vberkaltun/nodemcu-firmware-documentation/thesis-material/mq-all.png

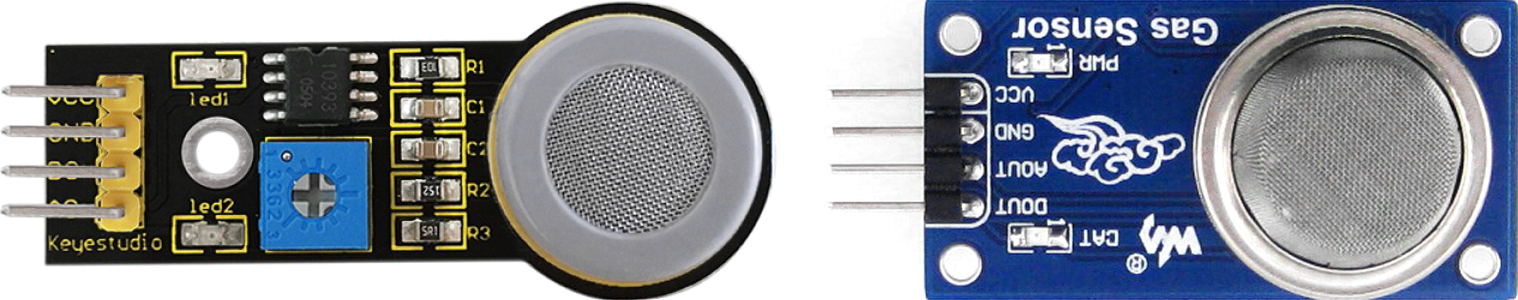
thesis-material/mq-all.png
