vberkaltun/nodemcu-firmware-documentation/thesis-material/IMG_8717.JPG

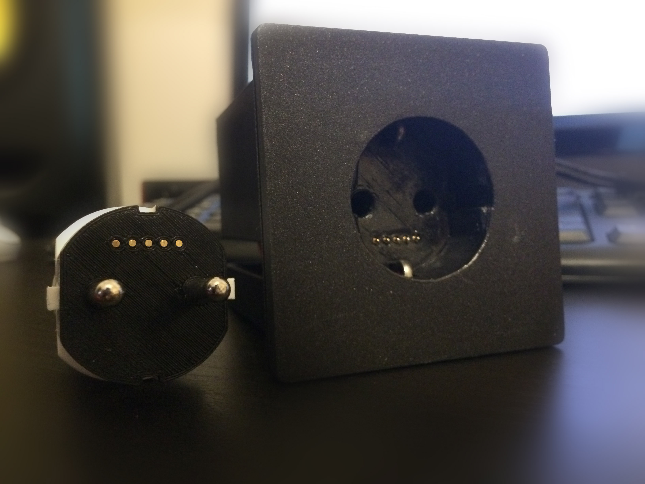
thesis-material/IMG_8717.JPG
