vberkaltun/nodemcu-firmware-documentation/thesis-structure/cover-out.docx

Pamukkale Üniversitesi, Mühendislik Fakültesi

Bilgisayar Mühendisliği Bölümü

Lisans Bitirme Tezi

Elektrik Sistemlerinin
Uzaktan Denetimi ve Yönetimi: intelliPWR

Tarafından

Veysel Berk ALTUN 13253004

Denetleyen

Yrd. Doç. Dr. Elif HAYTAOĞLU

Mayıs 21, 2018

Denizli
