vberkaltun/nodemcu-firmware-documentation/thesis-material/ATmega328-pinout.png

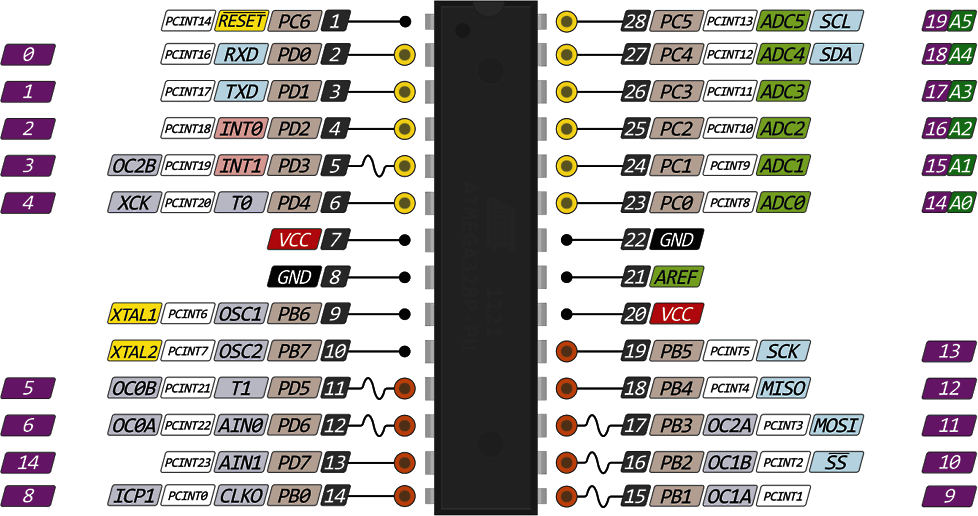
thesis-material/ATmega328-pinout.png
