vberkaltun/nodemcu-firmware-documentation/thesis-material/esp12-pinout.png

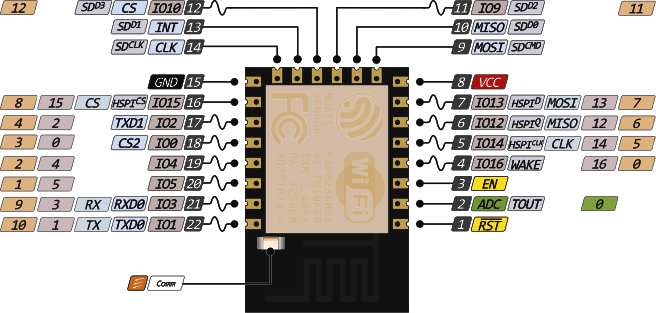
thesis-material/esp12-pinout.png
