vberkaltun/nodemcu-firmware-documentation/thesis-presentation/anime/anim_1.png

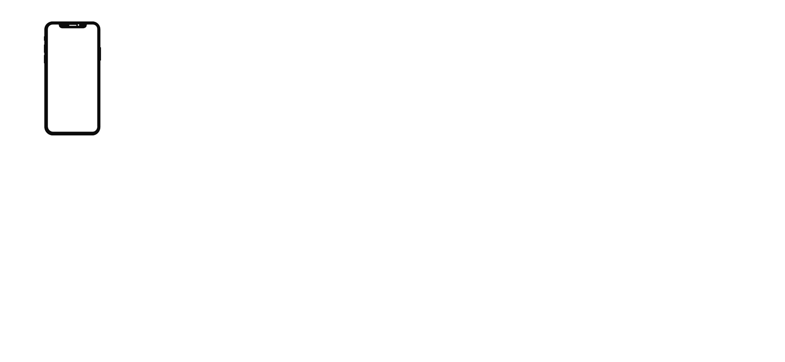
thesis-presentation/anime/anim_1.png
