vberkaltun/nodemcu-firmware-documentation/thesis-presentation/anime/anim_2.png

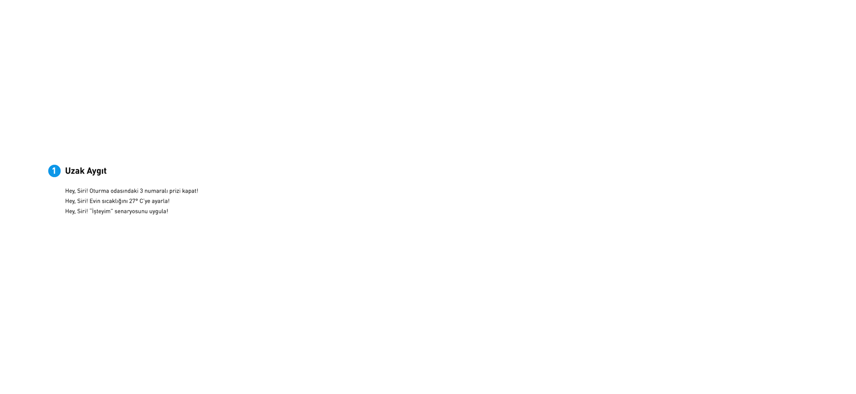
thesis-presentation/anime/anim_2.png
