vberkaltun/nodemcu-firmware-documentation/thesis-presentation/anime/anim_4.png

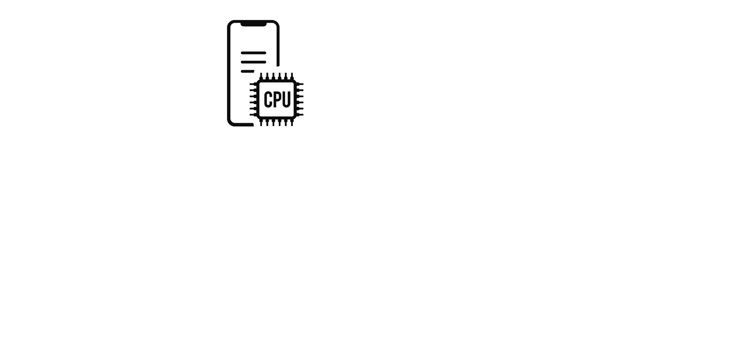
thesis-presentation/anime/anim_4.png
