vberkaltun/nodemcu-firmware-documentation/thesis-presentation/anime/anim_5.png

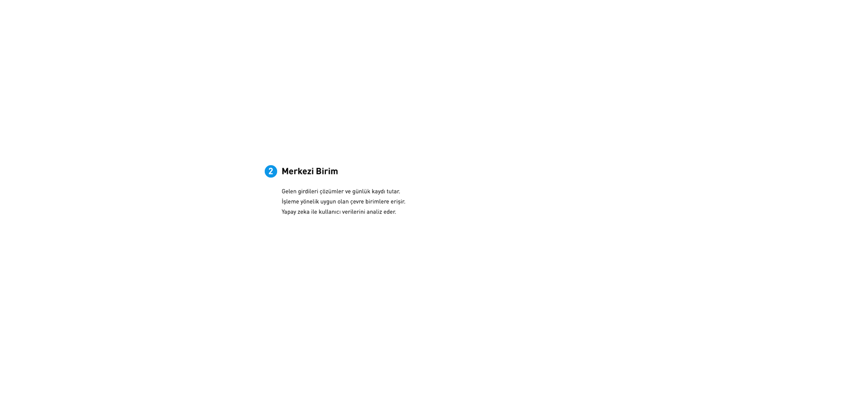
thesis-presentation/anime/anim_5.png
