vberkaltun/nodemcu-firmware-documentation/thesis-presentation/anime/anim_7.png

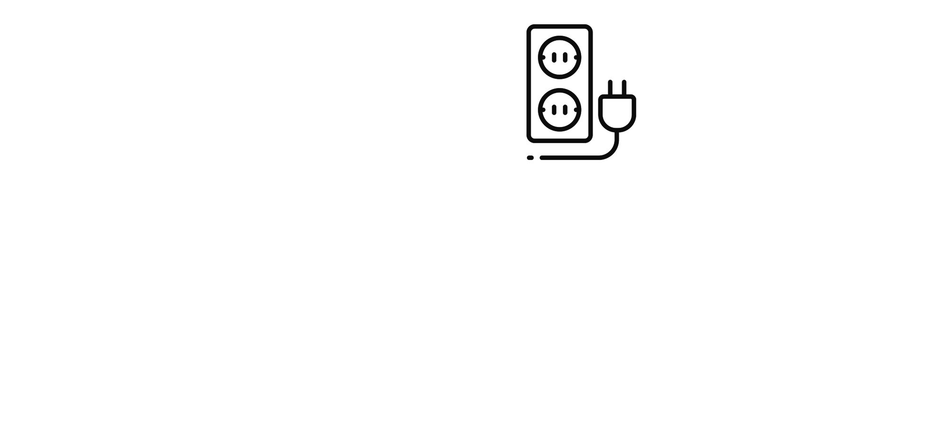
thesis-presentation/anime/anim_7.png
