vberkaltun/nodemcu-firmware-documentation/thesis-presentation/anime/anim_8.png

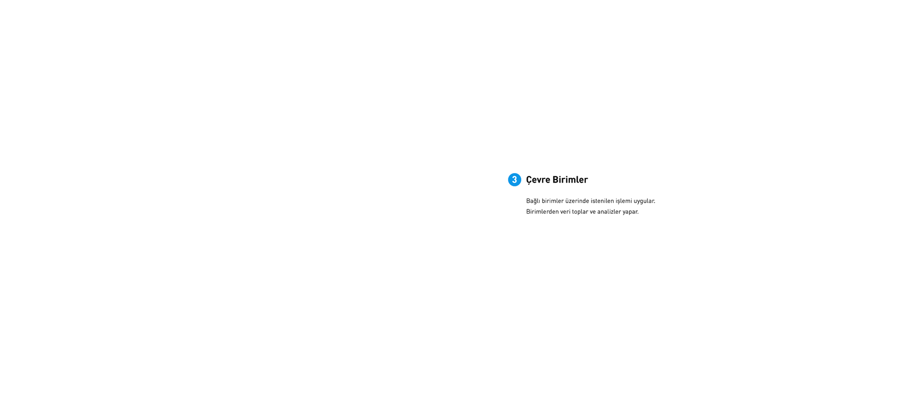
thesis-presentation/anime/anim_8.png
