vberkaltun/nodemcu-firmware-documentation/thesis-presentation/anime/anim_14.png

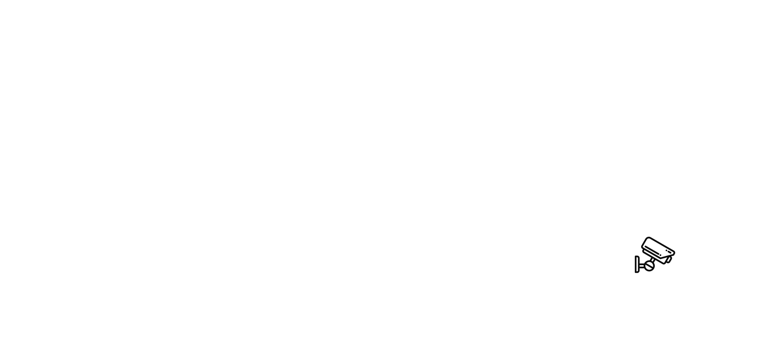
thesis-presentation/anime/anim_14.png
