vberkaltun/nodemcu-firmware-documentation/thesis-presentation/anime/anim_16.png

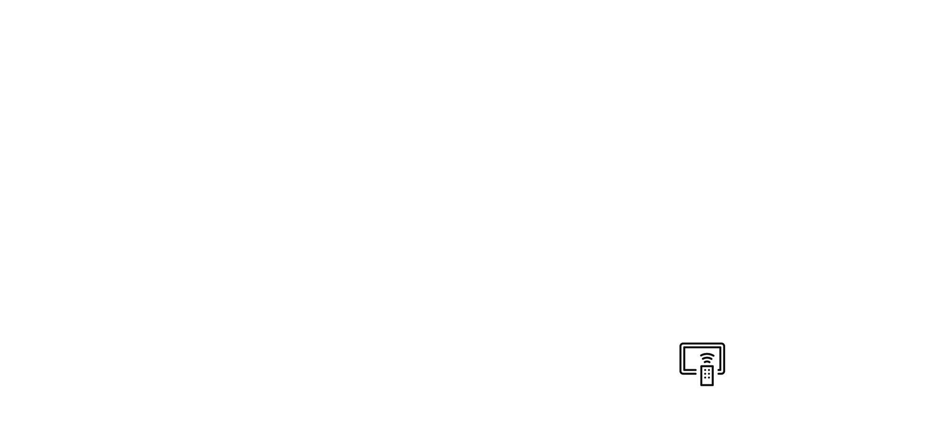
thesis-presentation/anime/anim_16.png
