vberkaltun/nodemcu-firmware-documentation/thesis-presentation/text/back_1.png

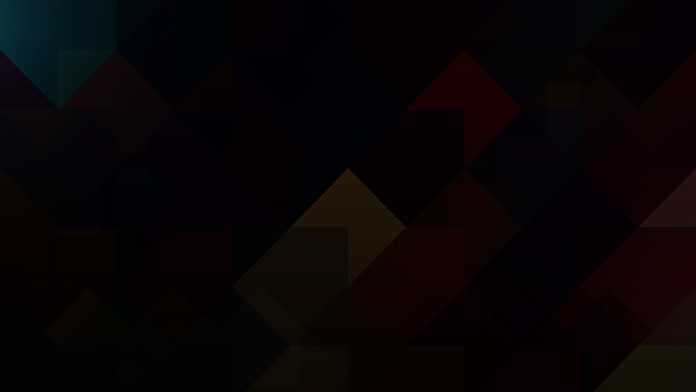
thesis-presentation/text/back_1.png
