vberkaltun/nodemcu-firmware-documentation/thesis-presentation/text/cap_2.png

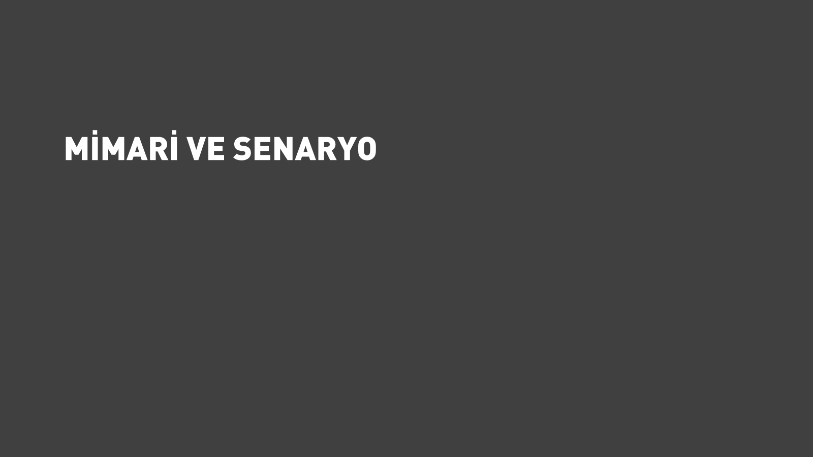
thesis-presentation/text/cap_2.png
