vberkaltun/nodemcu-firmware-documentation/thesis-presentation/text/cover_allinone_1.png

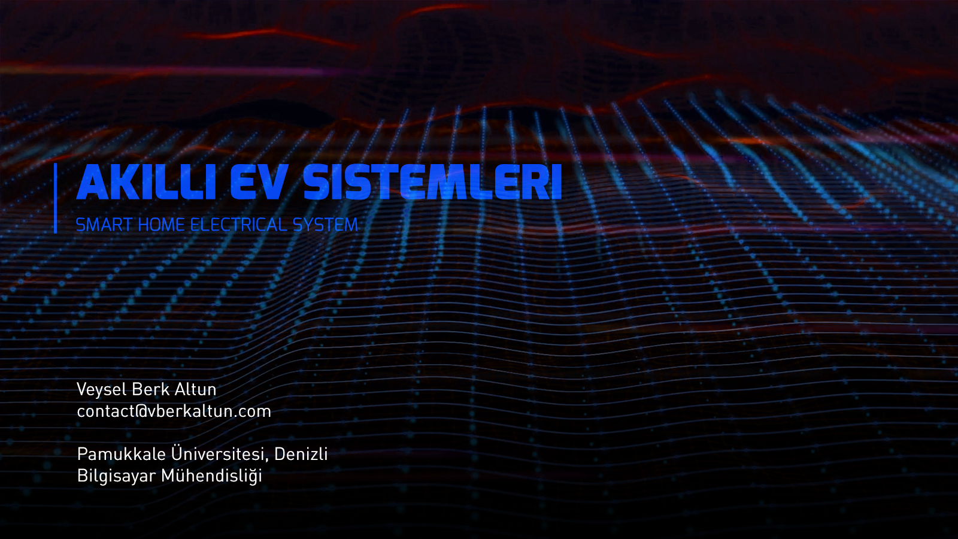
thesis-presentation/text/cover_allinone_1.png
