vberkaltun/nodemcu-firmware-documentation/thesis-presentation/text/cover_back.png

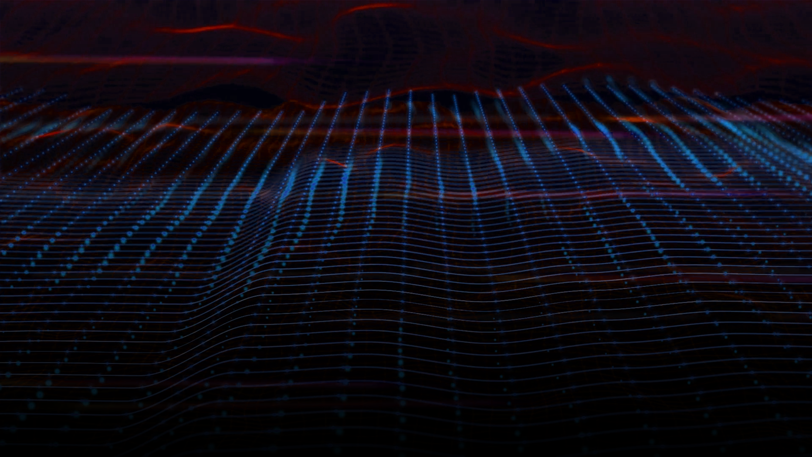
thesis-presentation/text/cover_back.png
