vberkaltun/nodemcu-firmware-documentation/thesis-presentation/text/cover_caption.png

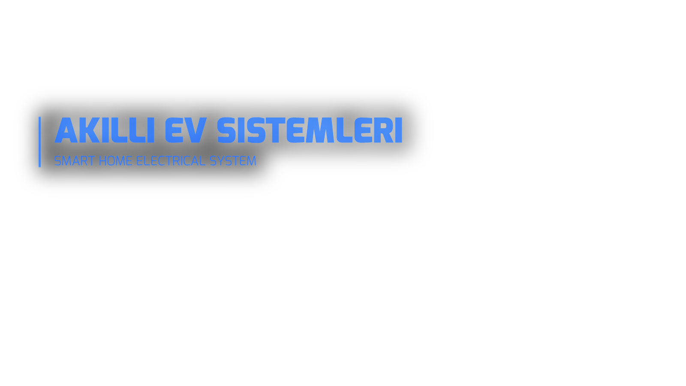
thesis-presentation/text/cover_caption.png
