vberkaltun/nodemcu-firmware-documentation/thesis-presentation/text/cover_subtitle.png

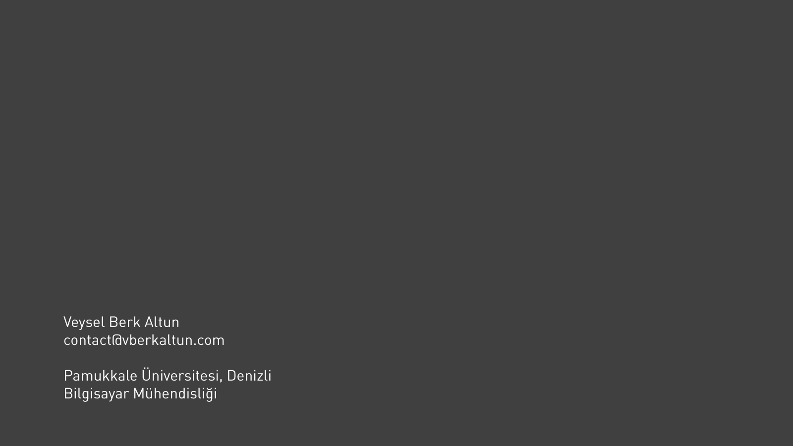
thesis-presentation/text/cover_subtitle.png
