vberkaltun/nodemcu-firmware-documentation/thesis-presentation/text/design_1.png

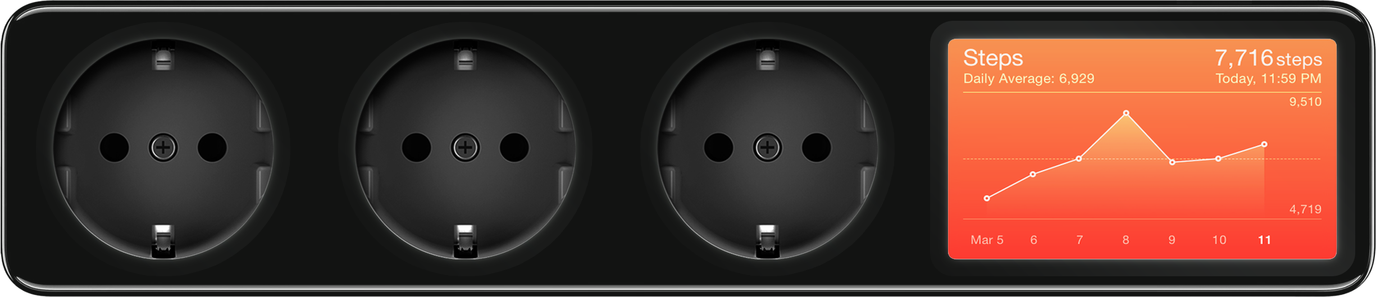
thesis-presentation/text/design_1.png
