vberkaltun/nodemcu-firmware-documentation/thesis-presentation/text/design_2.png

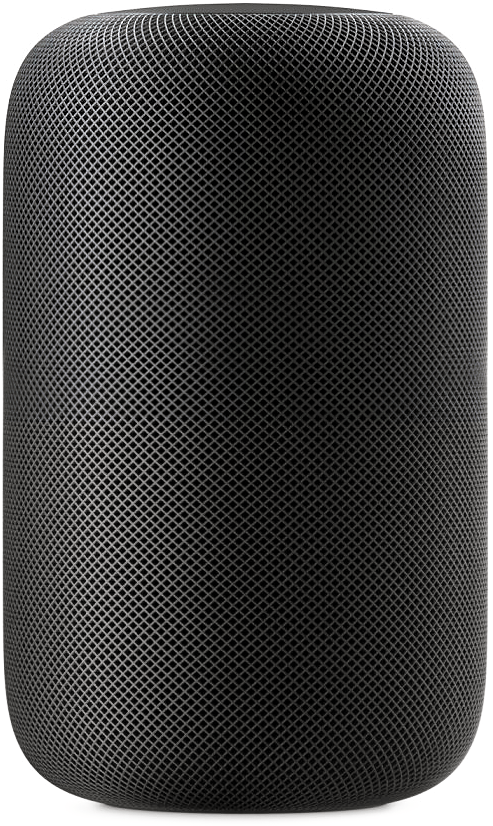
thesis-presentation/text/design_2.png
