vberkaltun/nodemcu-firmware-documentation/thesis-presentation/text/text_1.png

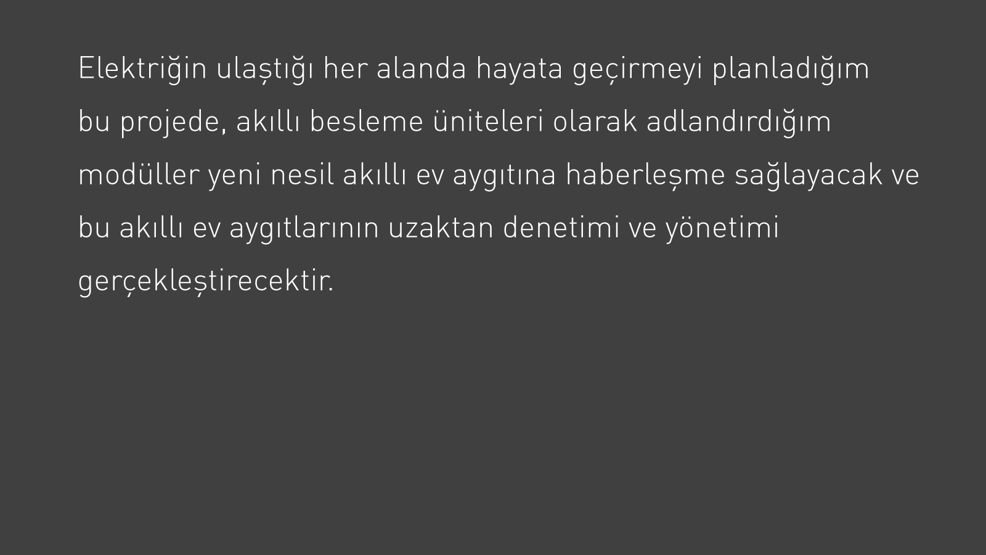
thesis-presentation/text/text_1.png
