vberkaltun/nodemcu-firmware-documentation/thesis-presentation/text/text_2.png

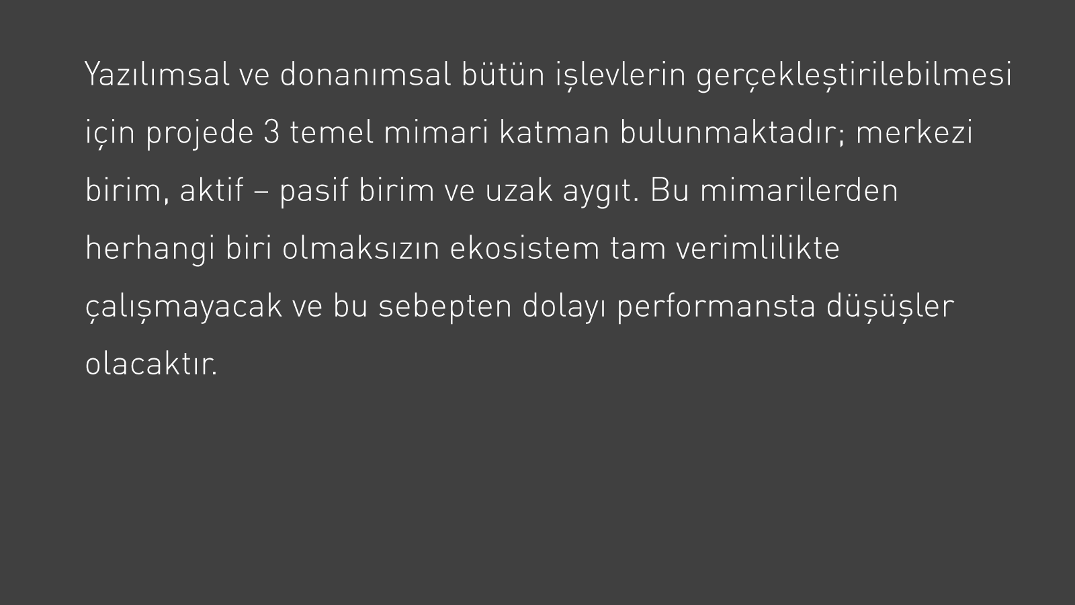
thesis-presentation/text/text_2.png
