vberkaltun/nodemcu-firmware-documentation/thesis-presentation/text/text_3.png

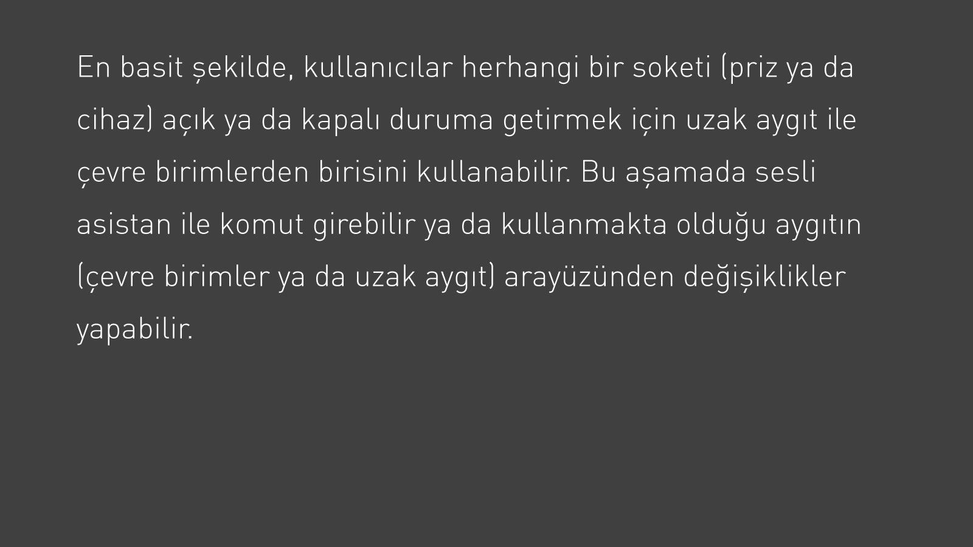
thesis-presentation/text/text_3.png
