vberkaltun/nodemcu-firmware-documentation/thesis-presentation/text/text_4.png

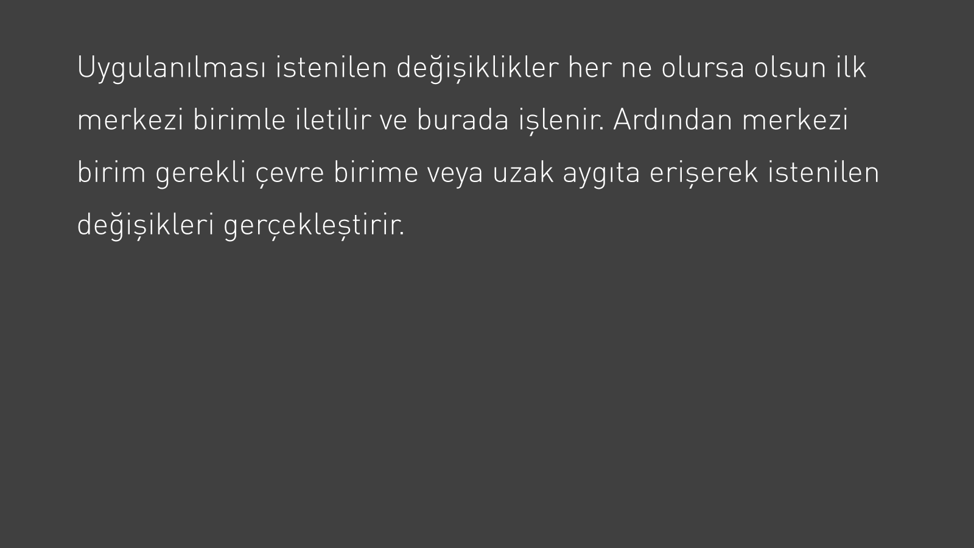
thesis-presentation/text/text_4.png
