vberkaltun/nodemcu-firmware-documentation/thesis-presentation/text/text_5.png

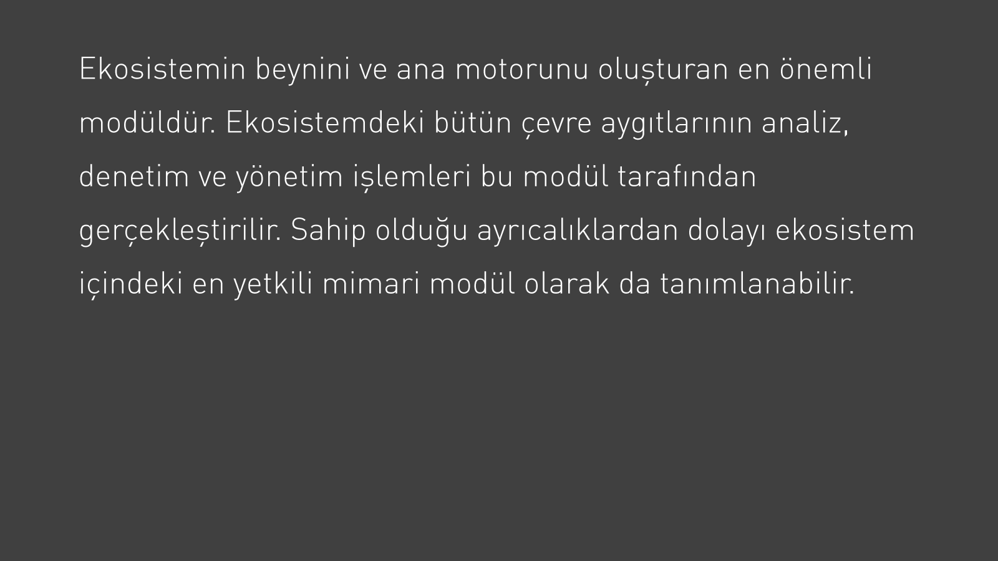
thesis-presentation/text/text_5.png
