vberkaltun/nodemcu-firmware-documentation/thesis-presentation/text/text_6.png

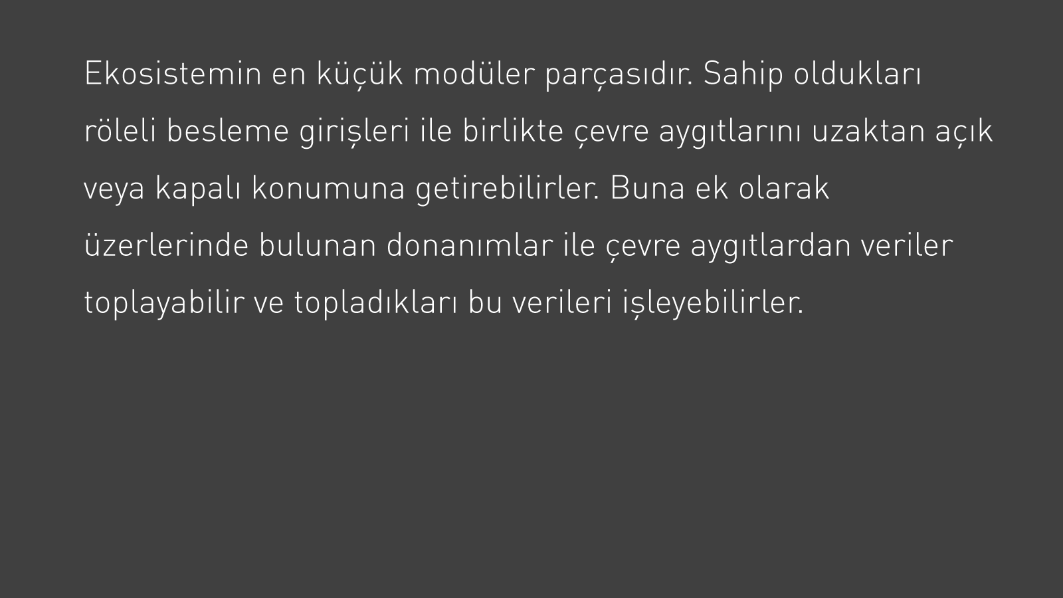
thesis-presentation/text/text_6.png
