vberkaltun/nodemcu-firmware-documentation/thesis-presentation/text/text_7.png

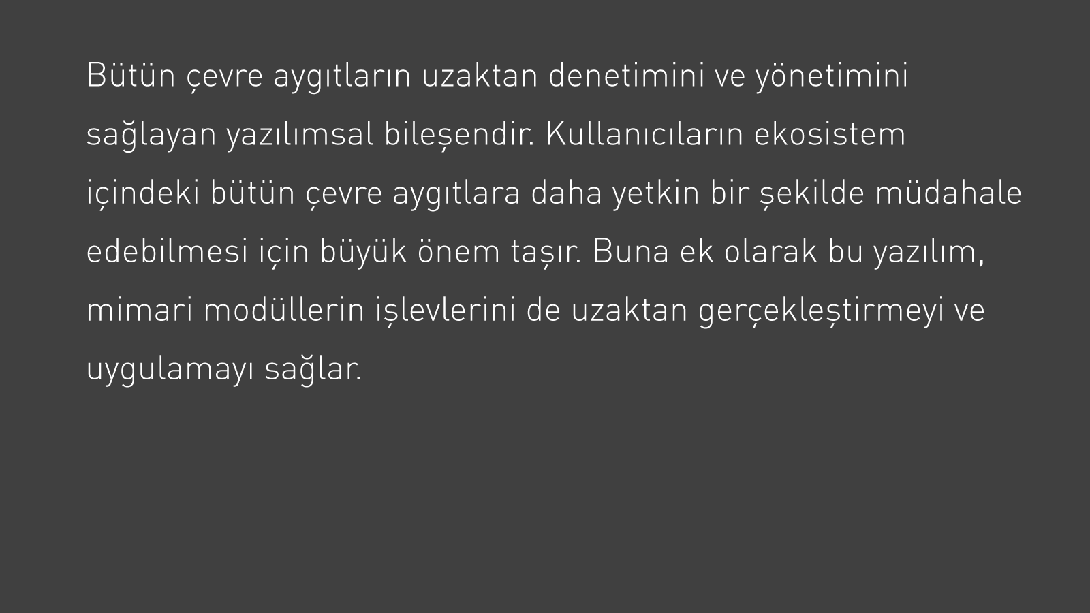
thesis-presentation/text/text_7.png
