vberkaltun/nodemcu-firmware-documentation/thesis-presentation/text/text_8.png

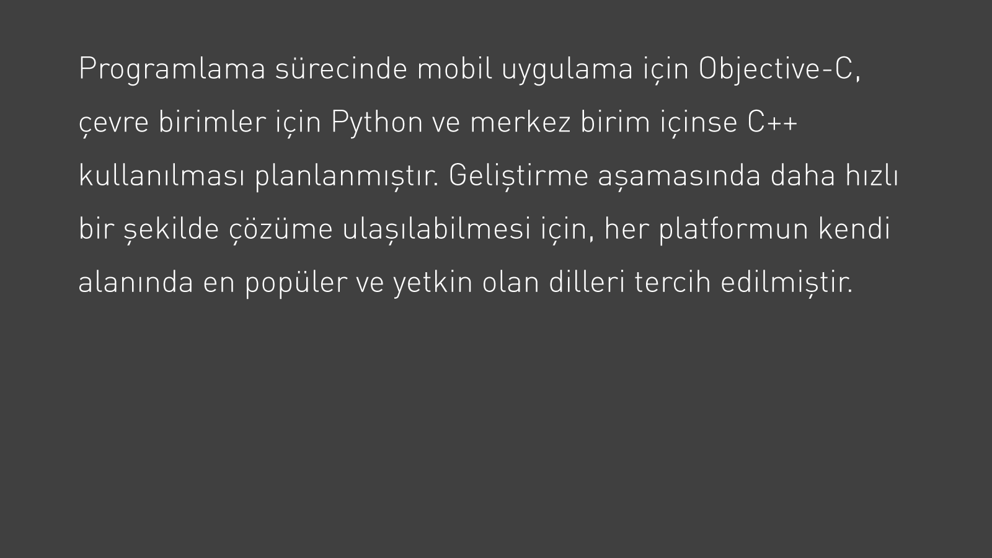
thesis-presentation/text/text_8.png
