vberkaltun/nodemcu-firmware-documentation/thesis-presentation/text/text_9.png

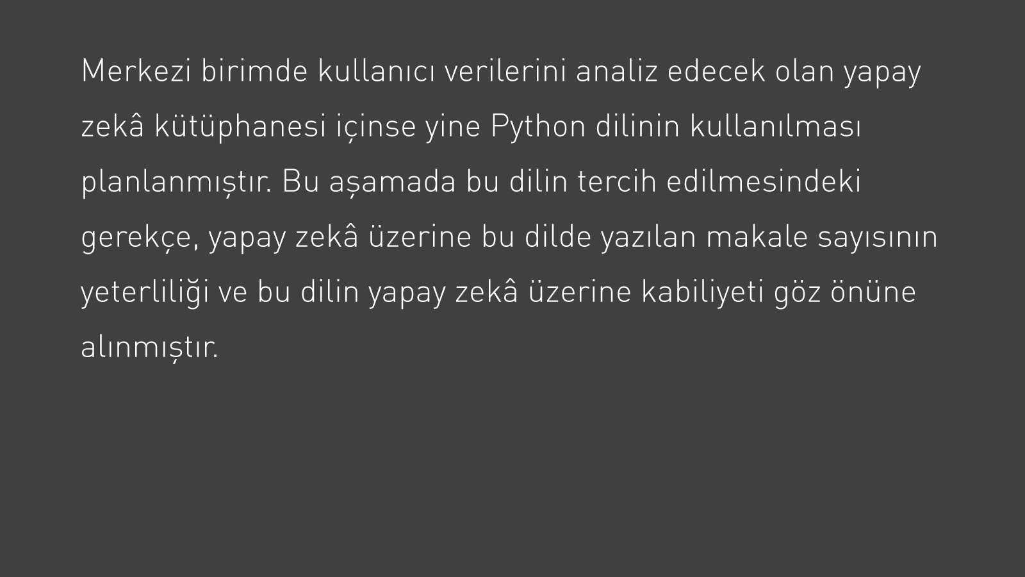
thesis-presentation/text/text_9.png
