vberkaltun/nodemcu-firmware-documentation/thesis-presentation/text/text_10.png

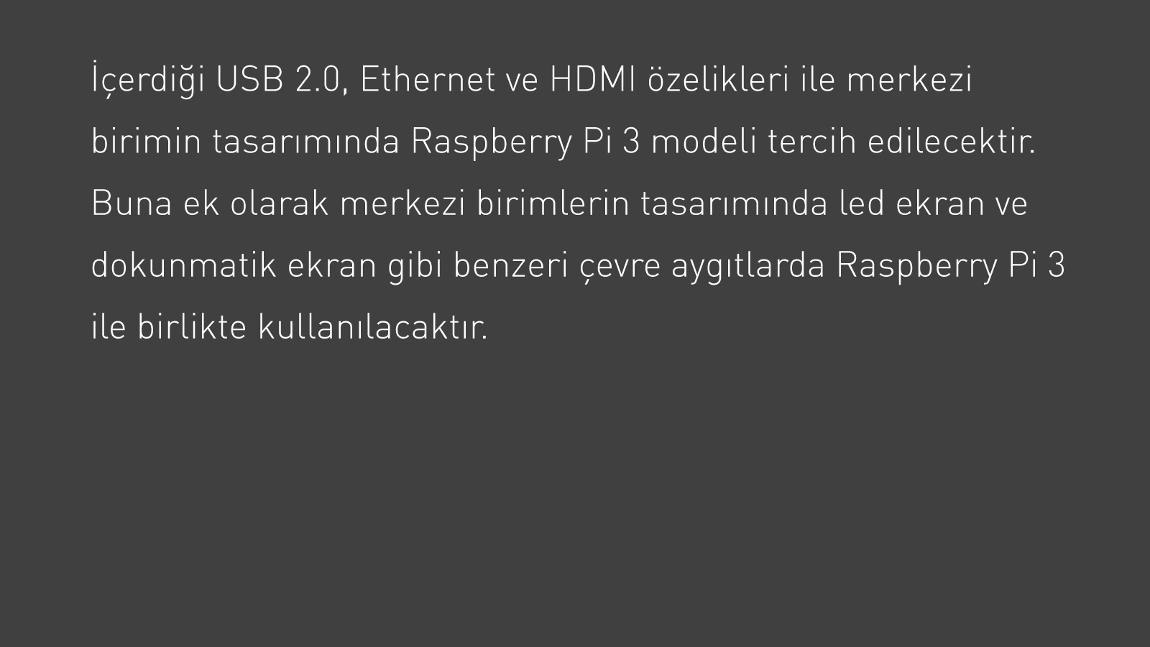
thesis-presentation/text/text_10.png
