vberkaltun/nodemcu-firmware-documentation/thesis-presentation/text/text_11.png

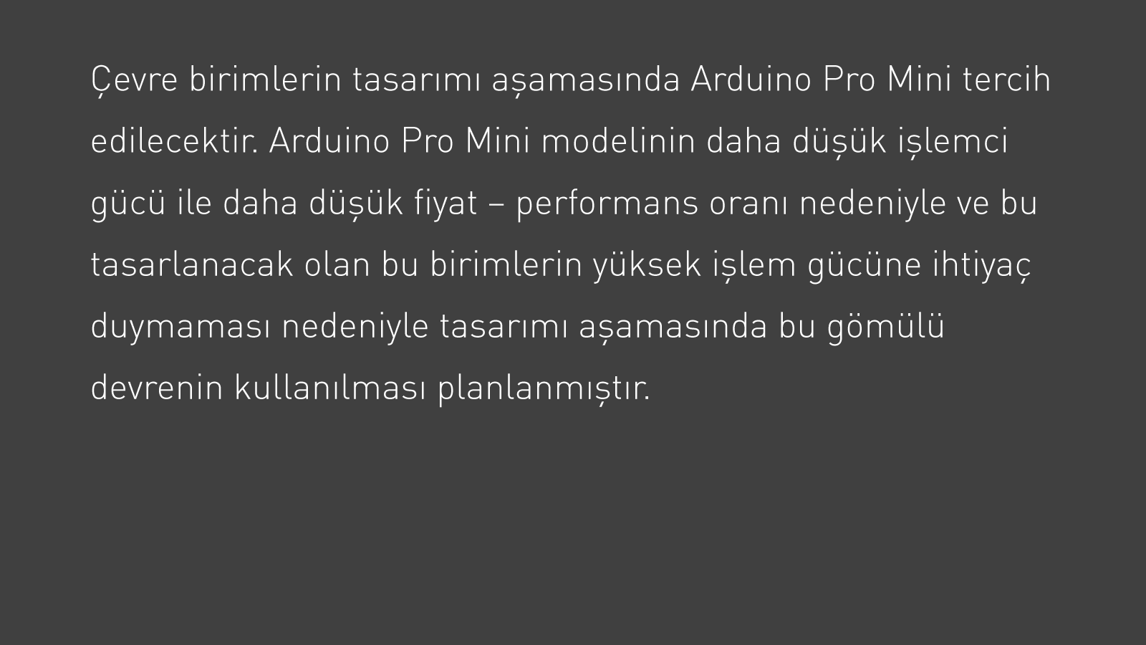
thesis-presentation/text/text_11.png
