vberkaltun/nodemcu-firmware-documentation/thesis-presentation/text/text_12.png

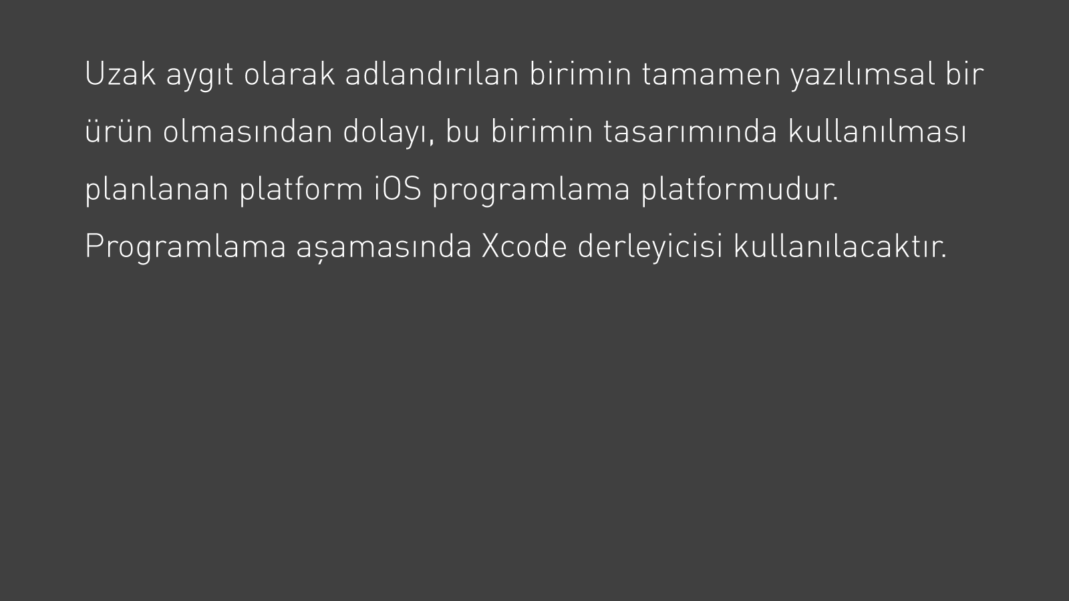
thesis-presentation/text/text_12.png
