vberkaltun/nodemcu-firmware-documentation/thesis-presentation/text/text_13.png

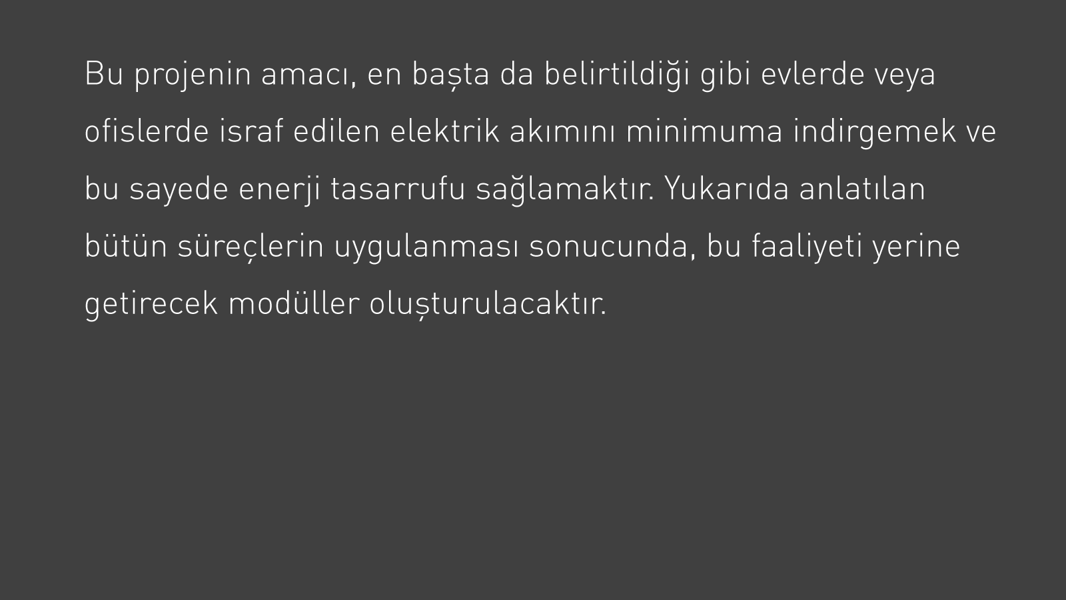
thesis-presentation/text/text_13.png
