vberkaltun/nodemcu-firmware-documentation/thesis-presentation/text/text_14.png

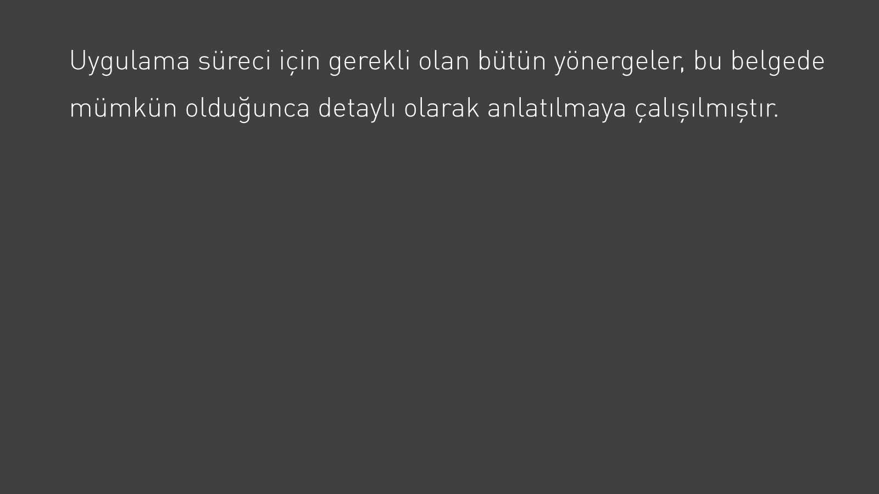
thesis-presentation/text/text_14.png
