vberkaltun/nodemcu-firmware-documentation/thesis-material/4-channel-ssr.jpg

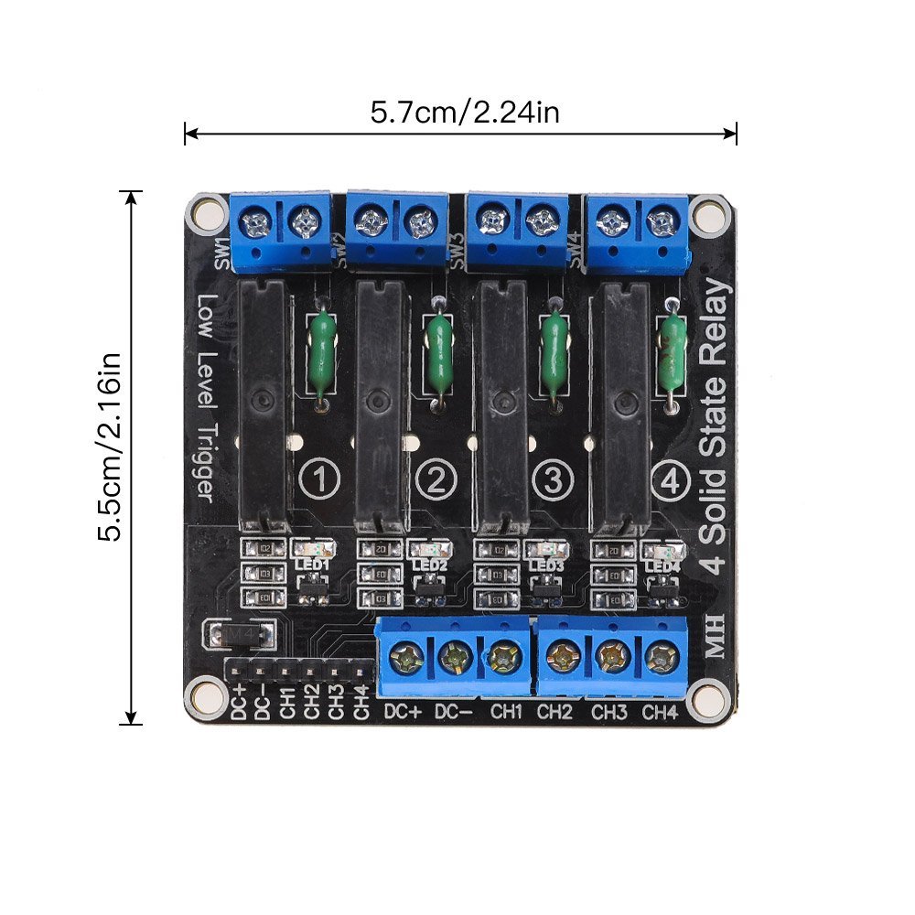
thesis-material/4-channel-ssr.jpg
