vberkaltun/nodemcu-firmware-documentation/thesis-material/4-channel-ssr.png

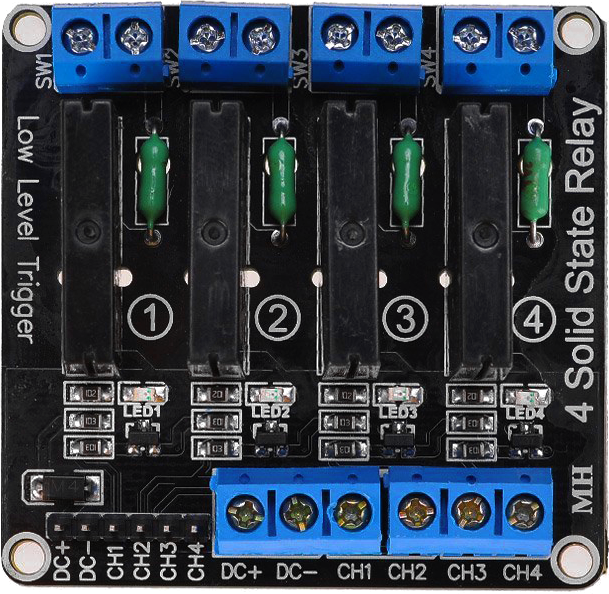
thesis-material/4-channel-ssr.png
