vberkaltun/nodemcu-firmware-documentation/thesis-material/cd-disc.png

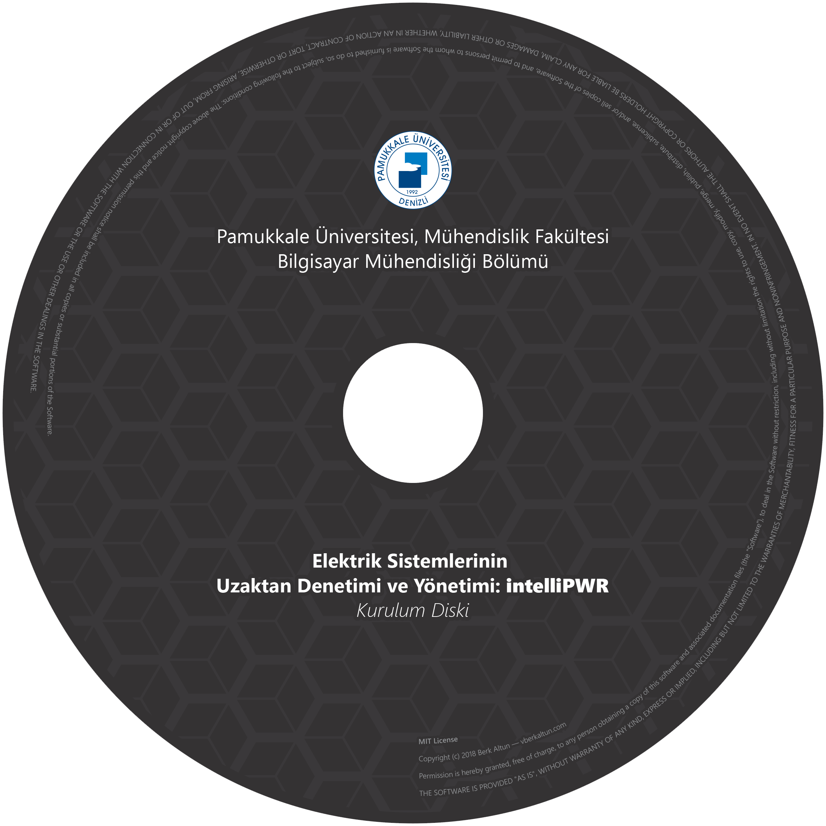
thesis-material/cd-disc.png
