vberkaltun/nodemcu-firmware-documentation/thesis-material/dht11-all.png

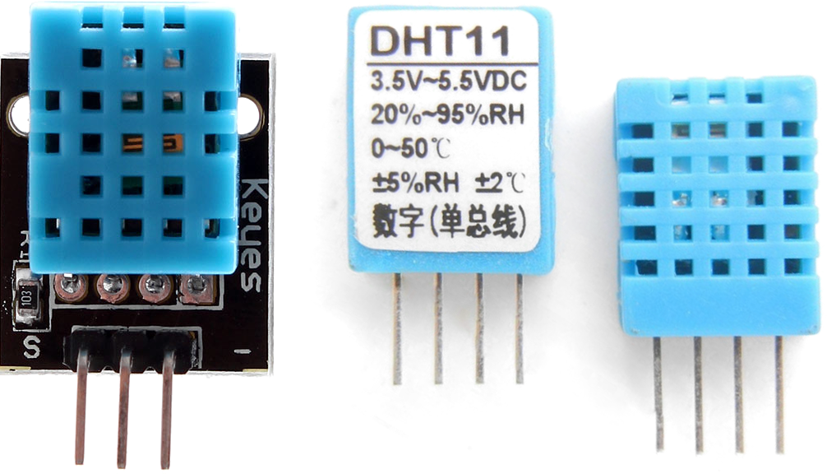
thesis-material/dht11-all.png
