vberkaltun/nodemcu-firmware-documentation/thesis-material/dht11-in.jpg

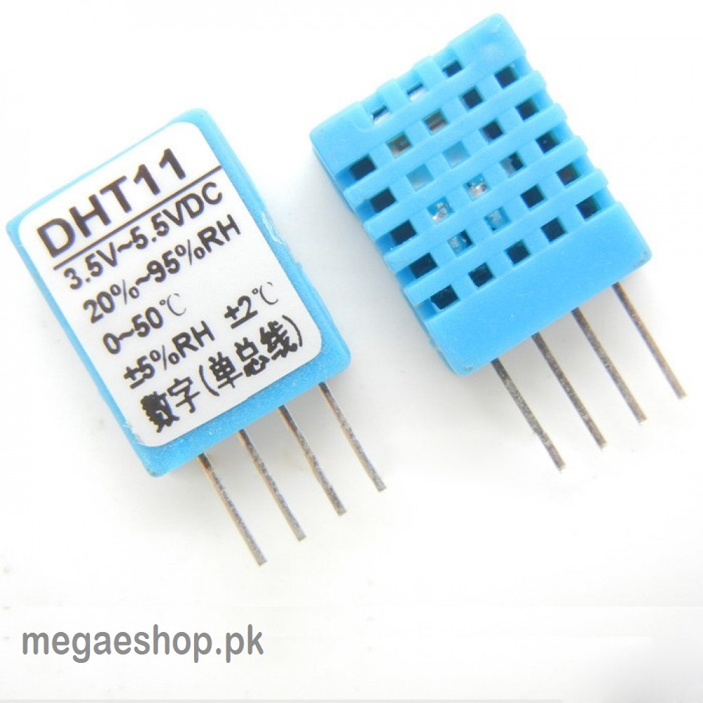
thesis-material/dht11-in.jpg
