vberkaltun/nodemcu-firmware-documentation/thesis-material/dht11.jpg

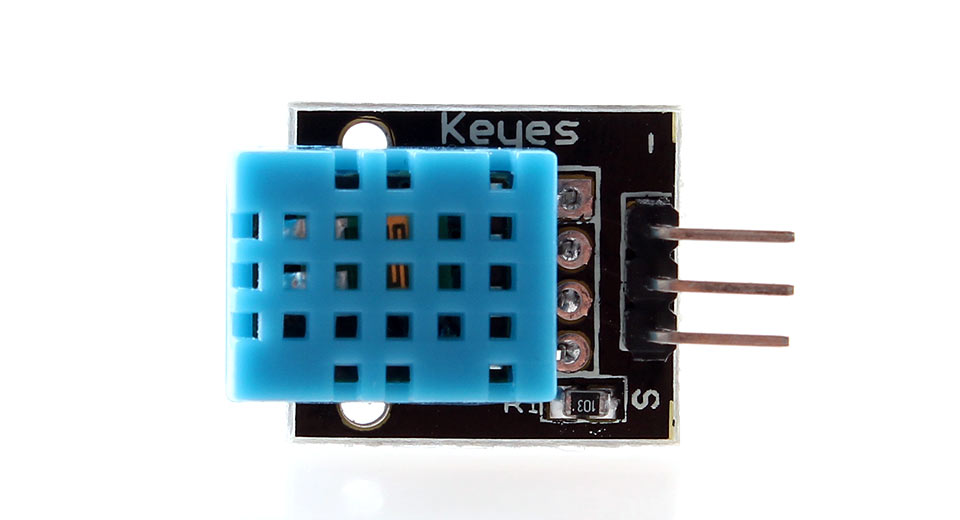
thesis-material/dht11.jpg
