vberkaltun/nodemcu-firmware-documentation/thesis-material/fotek-40da-ssr.jpg

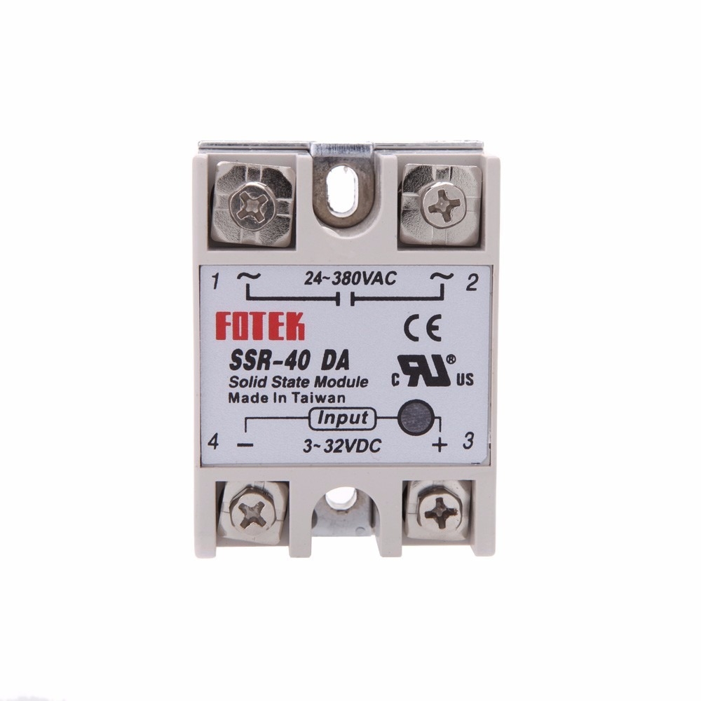
thesis-material/fotek-40da-ssr.jpg
