vberkaltun/nodemcu-firmware-documentation/thesis-material/fotek-40da-ssr.png

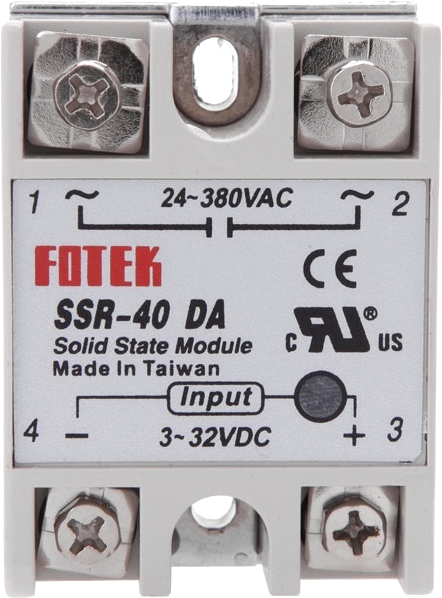
thesis-material/fotek-40da-ssr.png
