vberkaltun/nodemcu-firmware-documentation/thesis-material/IMG_8718.JPG

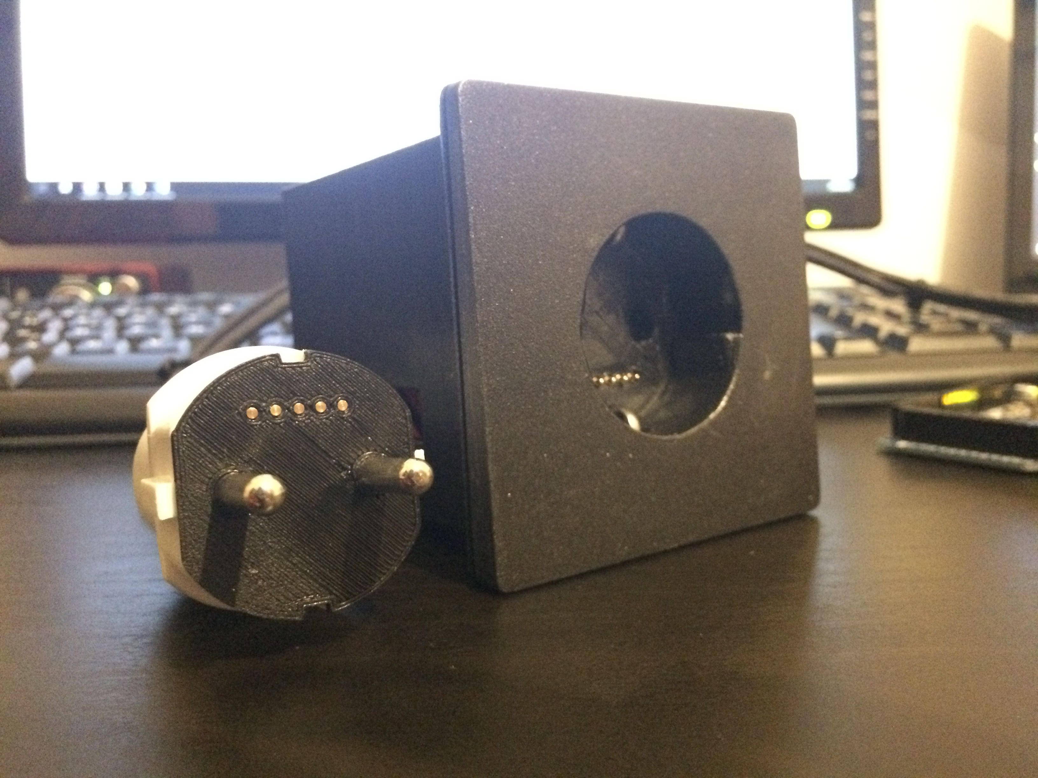
thesis-material/IMG_8718.JPG
