vberkaltun/nodemcu-firmware-documentation/thesis-material/IMG_8719.JPG

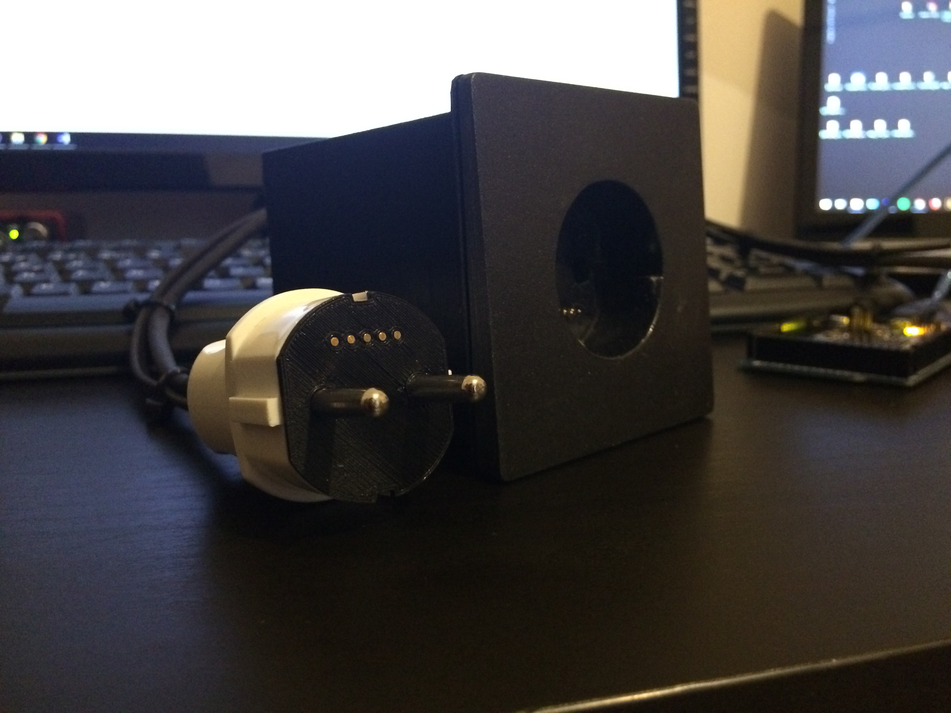
thesis-material/IMG_8719.JPG
