vberkaltun/nodemcu-firmware-documentation/thesis-material/IMG_8729.JPG

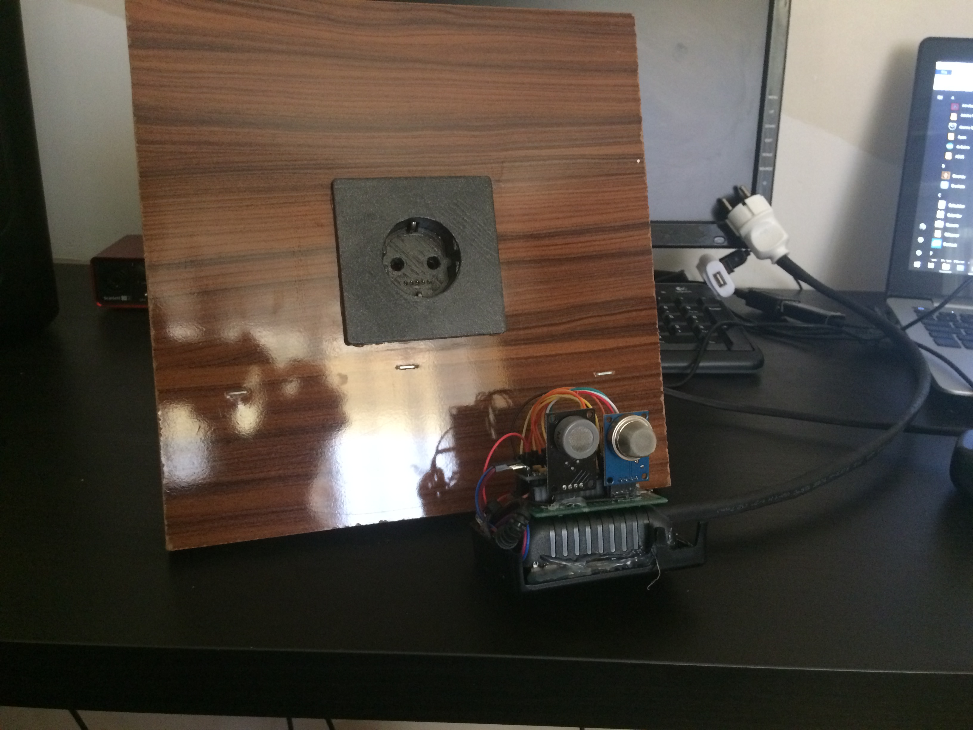
thesis-material/IMG_8729.JPG
