vberkaltun/nodemcu-firmware-documentation/thesis-material/IMG_8730.JPG

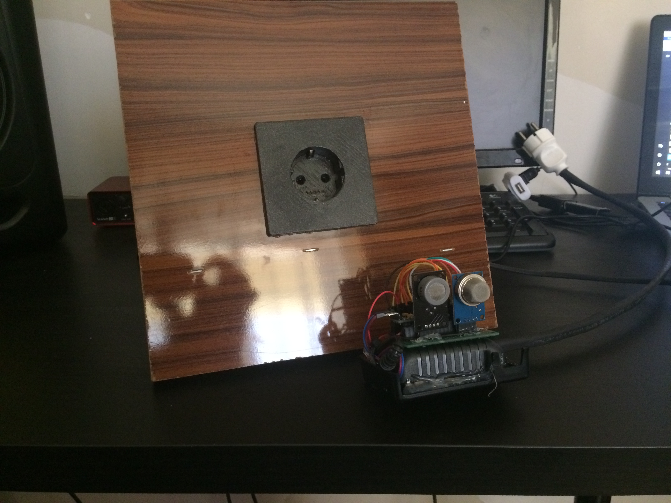
thesis-material/IMG_8730.JPG
