vberkaltun/nodemcu-firmware-documentation/thesis-material/IMG_8731.JPG

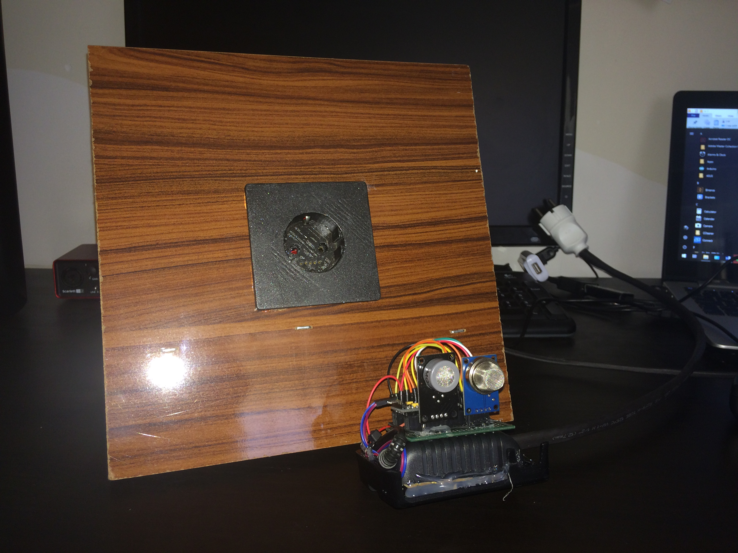
thesis-material/IMG_8731.JPG
