vberkaltun/nodemcu-firmware-documentation/thesis-material/mq-2.jpg

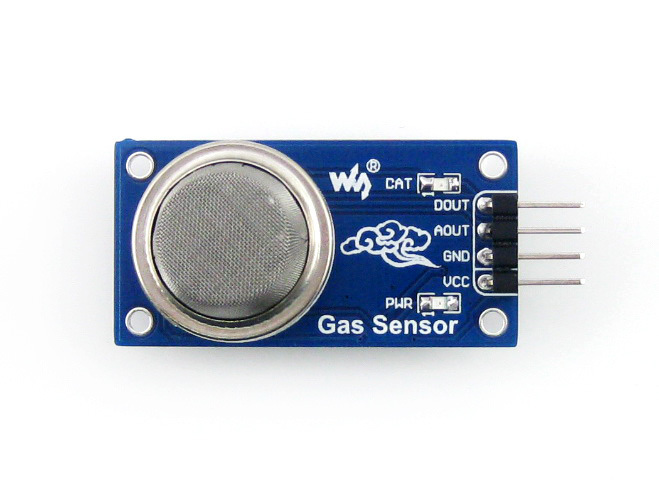
thesis-material/mq-2.jpg
