vberkaltun/nodemcu-firmware-documentation/thesis-material/mq-7.jpg

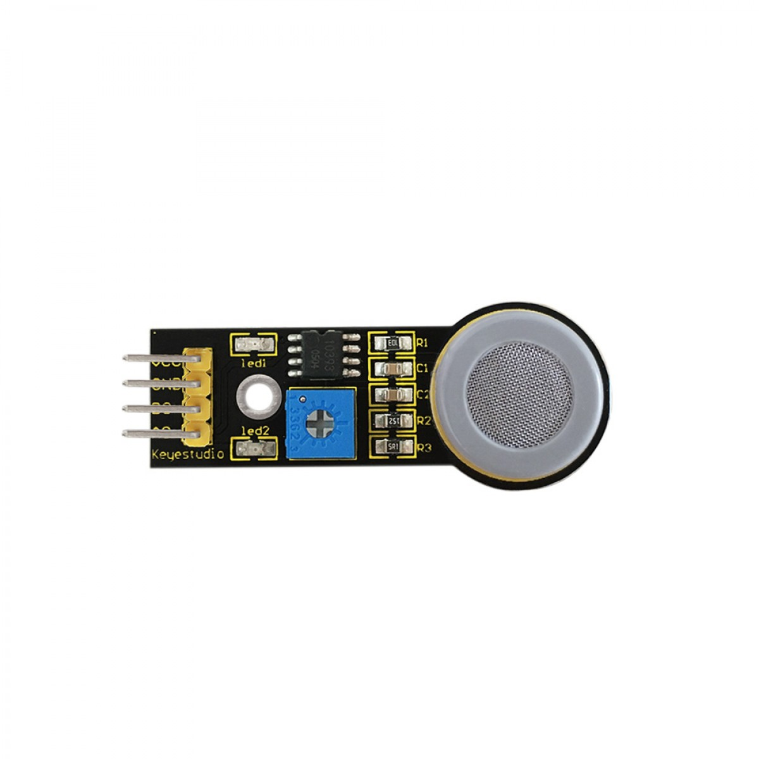
thesis-material/mq-7.jpg
