vberkaltun/nodemcu-firmware-documentation/thesis-material/pogo-pin1.png

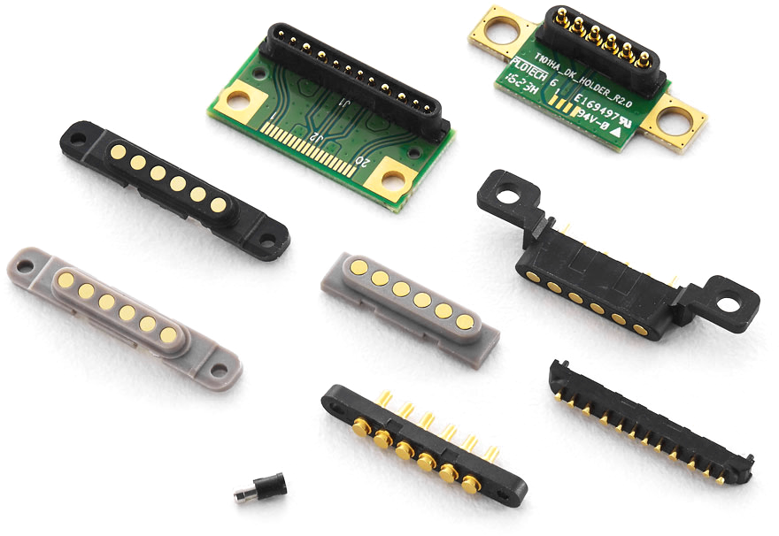
thesis-material/pogo-pin1.png
