vberkaltun/nodemcu-firmware-documentation/thesis-material/pogo-pin2.png

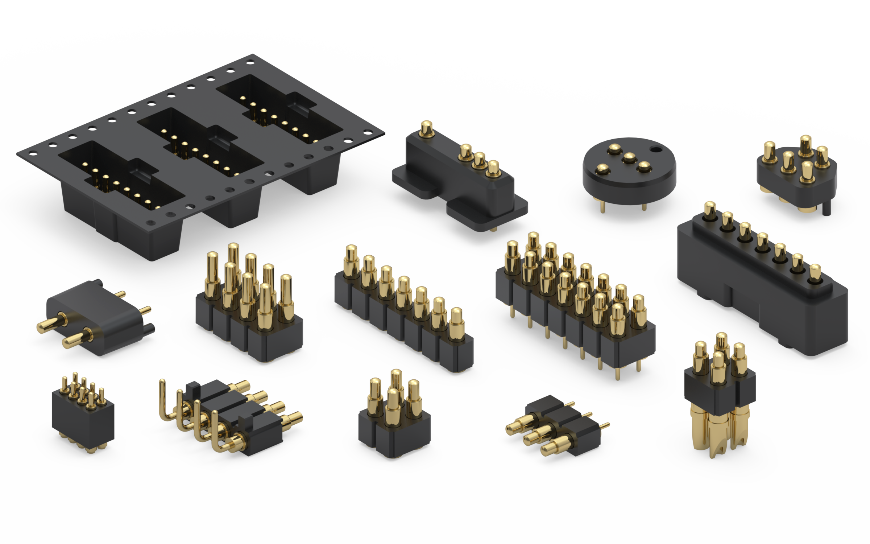
thesis-material/pogo-pin2.png
