vberkaltun/nodemcu-firmware-documentation/thesis-material/pogo-pin3.png

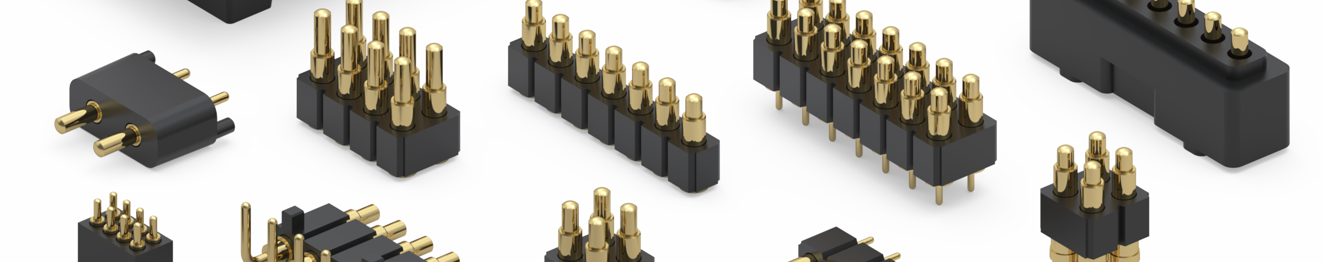
thesis-material/pogo-pin3.png
