vberkaltun/nodemcu-firmware-documentation/thesis-material/pogo-pin.jpg

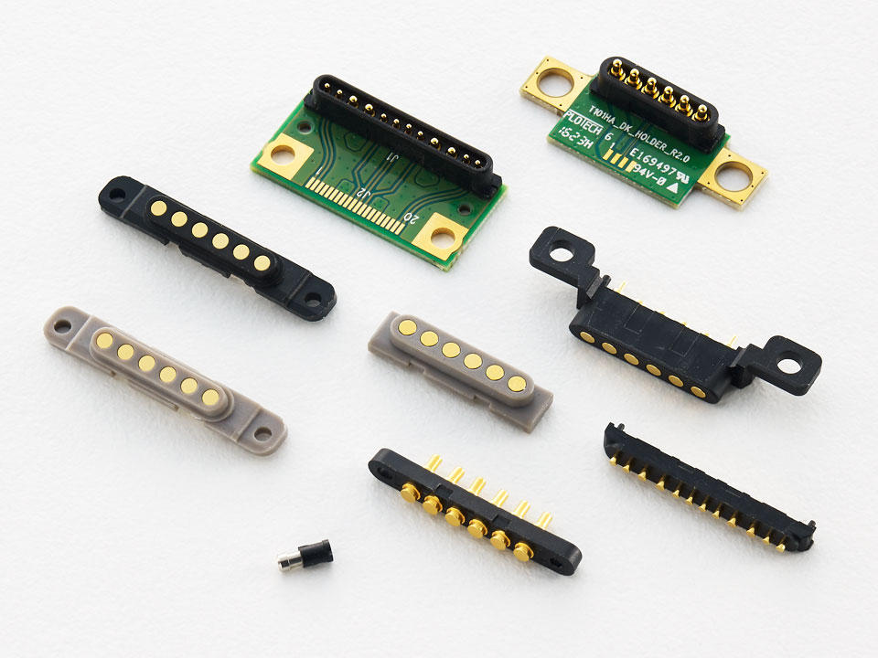
thesis-material/pogo-pin.jpg
