vberkaltun/nodemcu-firmware-documentation/thesis-material/pull-up.jpg

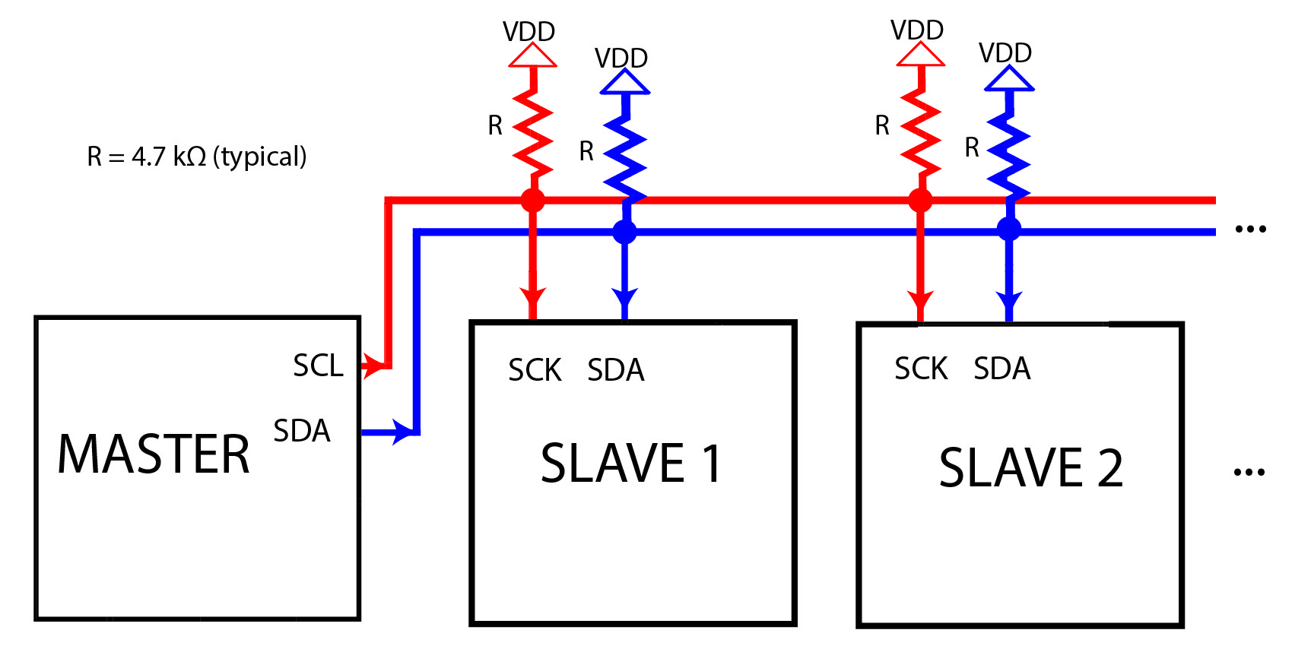
thesis-material/pull-up.jpg
