vberkaltun/nodemcu-firmware-documentation/thesis-material/pull-up.png

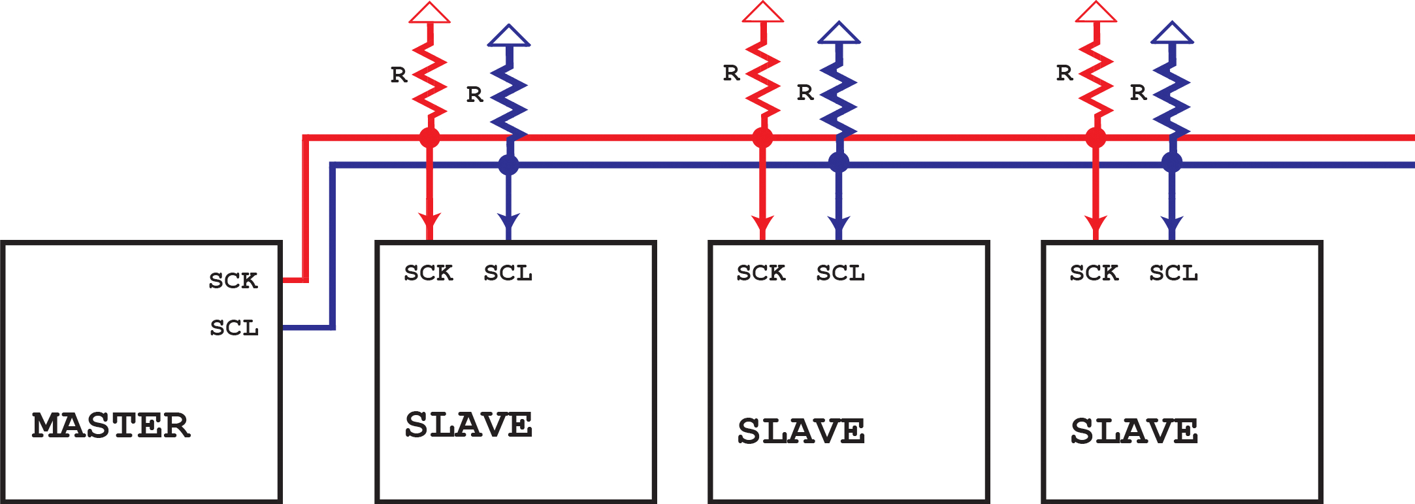
thesis-material/pull-up.png
