vberkaltun/nodemcu-firmware-documentation/thesis-material/socket-male-1.png

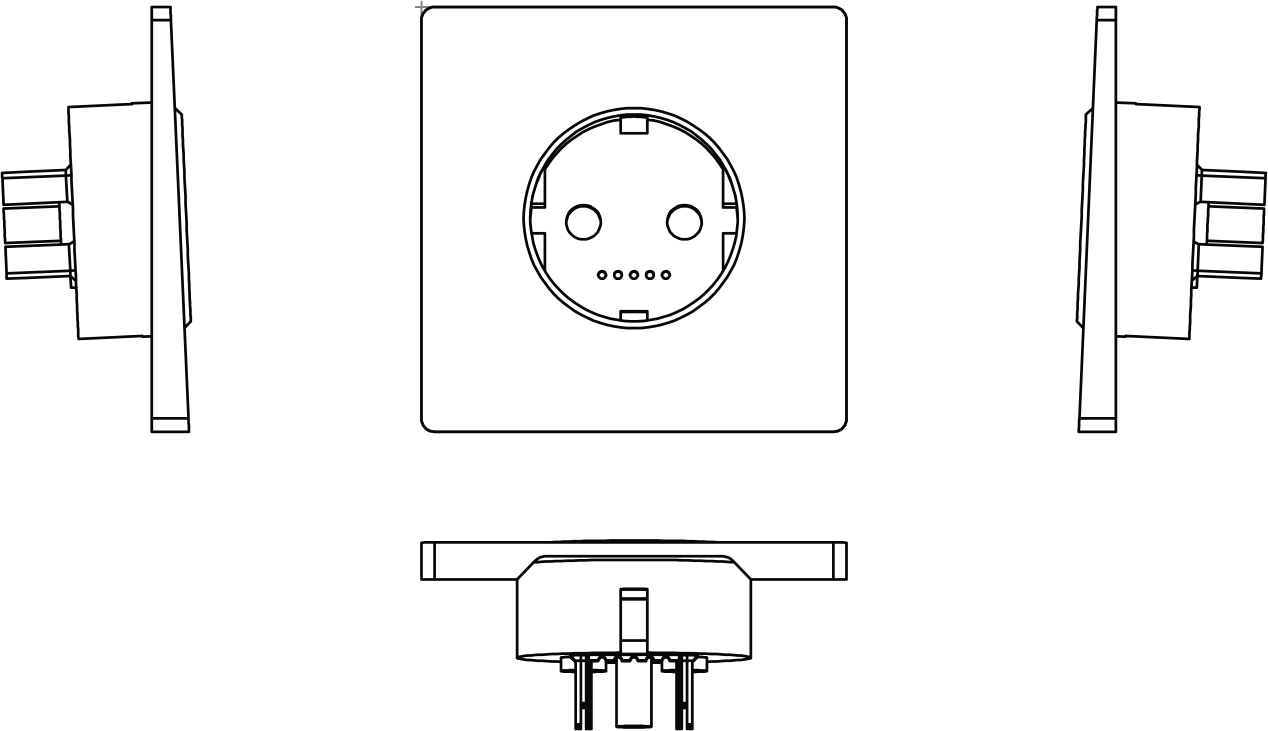
thesis-material/socket-male-1.png
