vberkaltun/nodemcu-firmware-documentation/thesis-material/socket-male-3.png

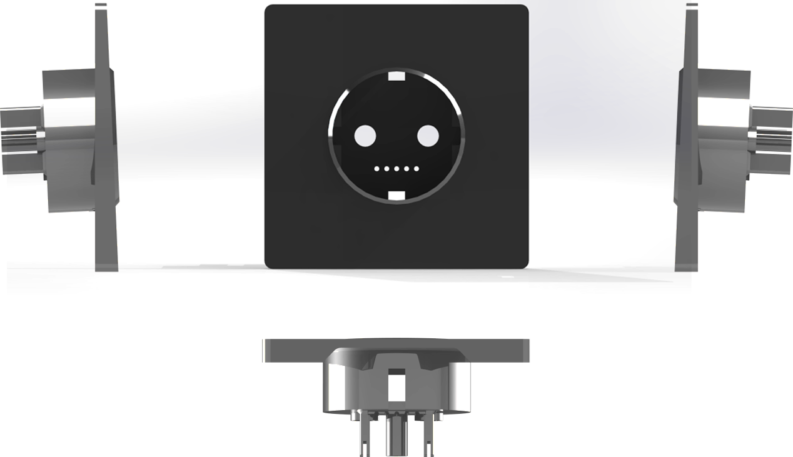
thesis-material/socket-male-3.png
