vberkaltun/nodemcu-firmware-documentation/thesis-material/socket-male.png

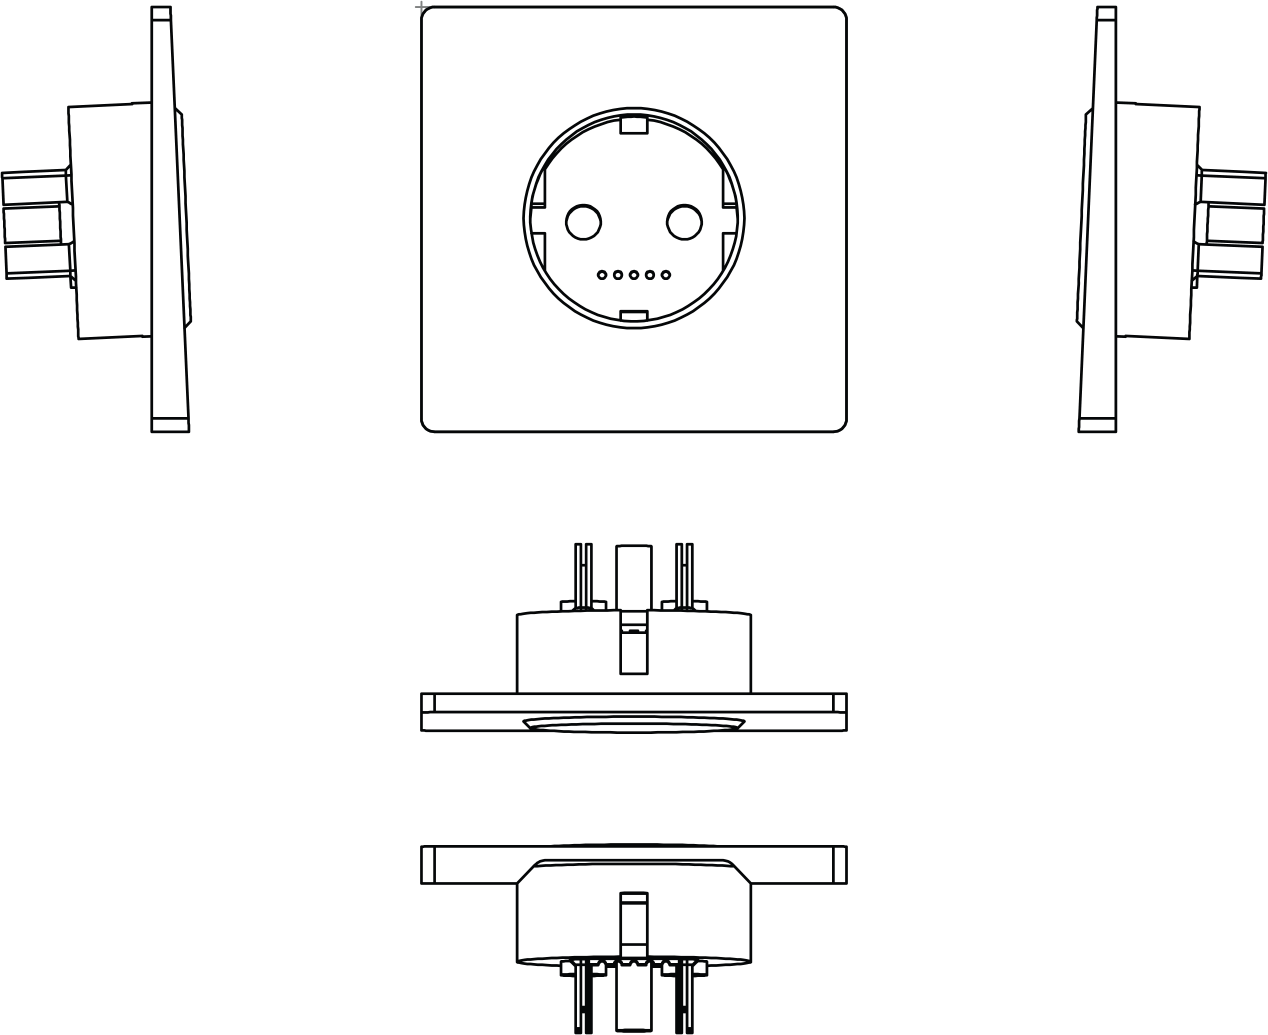
thesis-material/socket-male.png
