vberkaltun/nodemcu-firmware-documentation/3d-case-drawing/assembly-single.SLDASM

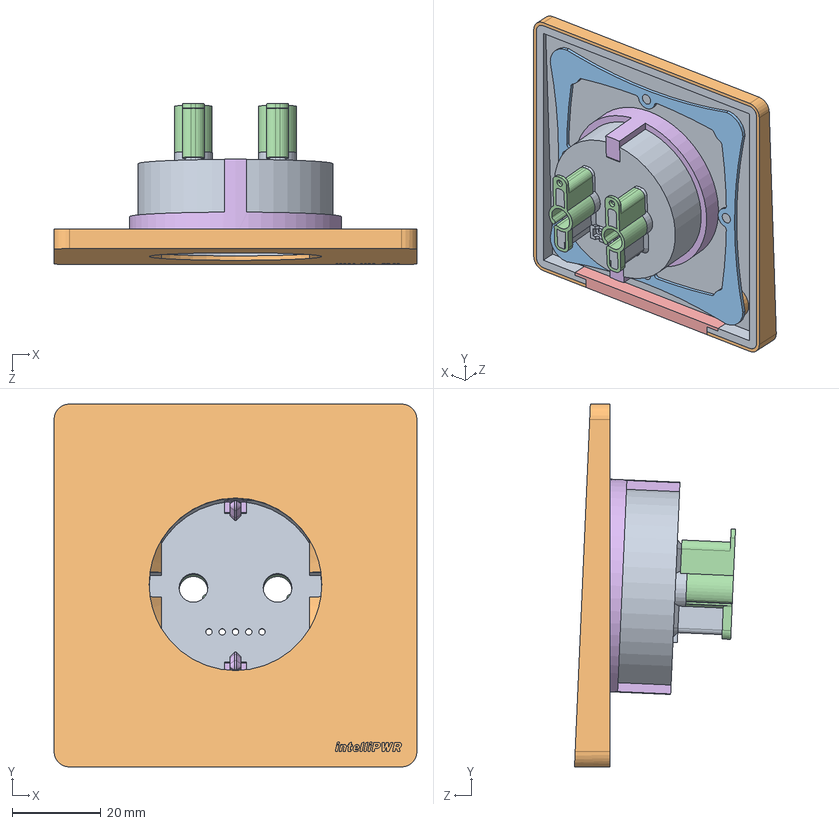
[picture p74: CAD file, 2018-08-08]
3d-case-drawing/assembly-single.SLDASM
82.0 x 82.0 x 36.4 mm
socket-single
socket-single-cover
socket-single-knuckle
socket-single-pin x 2
socket-single-led
socket-single-bonding
