vberkaltun/nodemcu-firmware-documentation/3d-case-drawing/assembly-multi.SLDASM

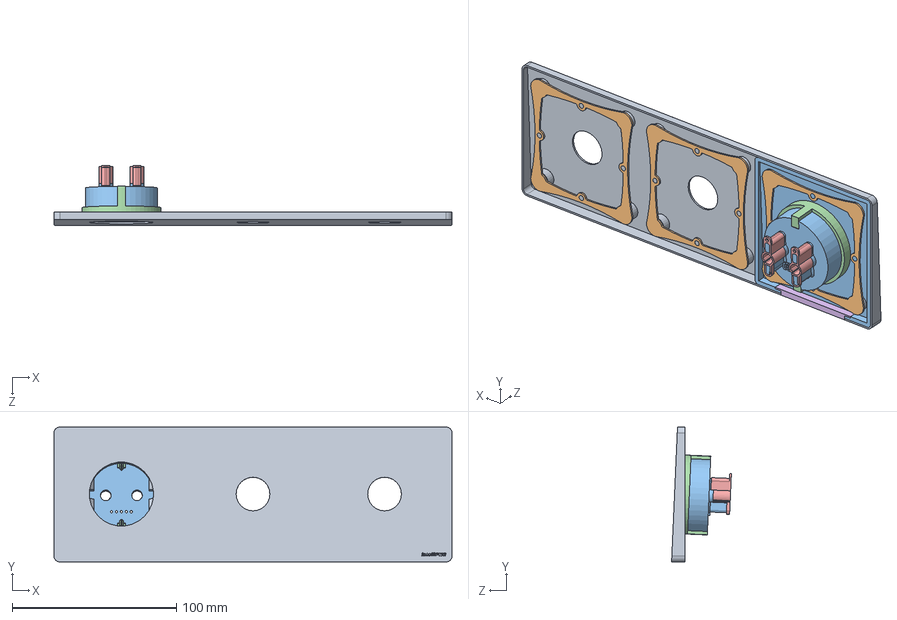
[picture p75: CAD file, 2018-08-08]
3d-case-drawing/assembly-multi.SLDASM
242.0 x 82.0 x 36.4 mm
socket-multi
socket-single-knuckle x 3
socket-single
socket-single-bonding
socket-single-pin x 2
socket-single-led
