vberkaltun/nodemcu-firmware-documentation/3d-case-drawing/socket-single-knuckle.SLDPRT

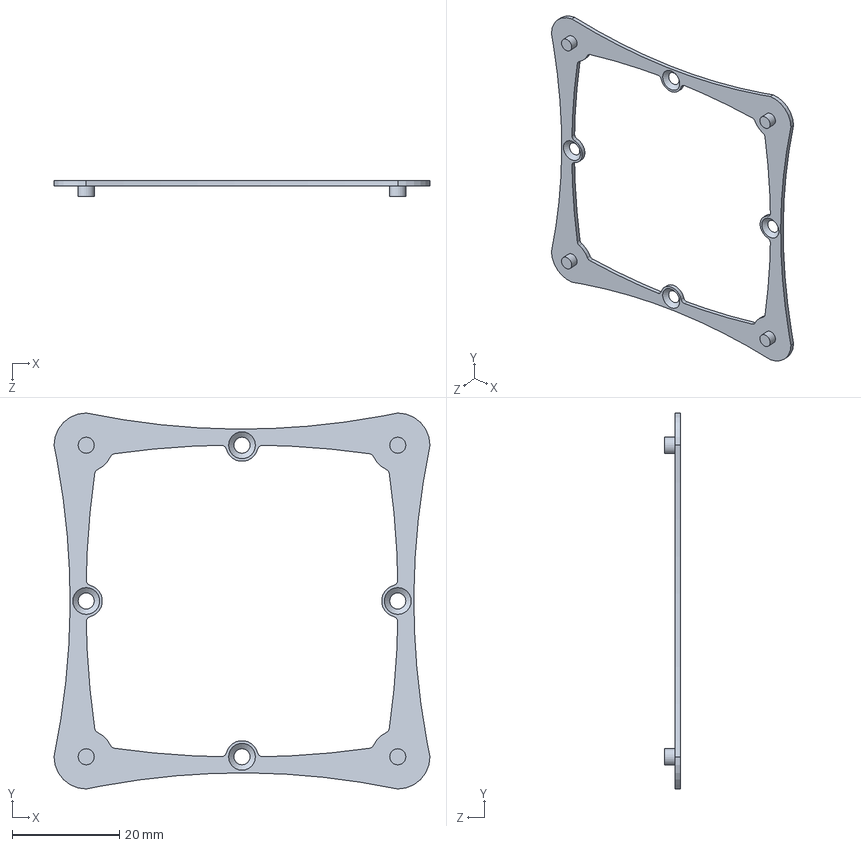
[picture p76: CAD file, 2018-08-08]
3d-case-drawing/socket-single-knuckle.SLDPRT
70.0 x 70.0 x 3.00 mm
