vberkaltun/nodemcu-firmware-documentation/3d-case-drawing/socket-single.SLDPRT

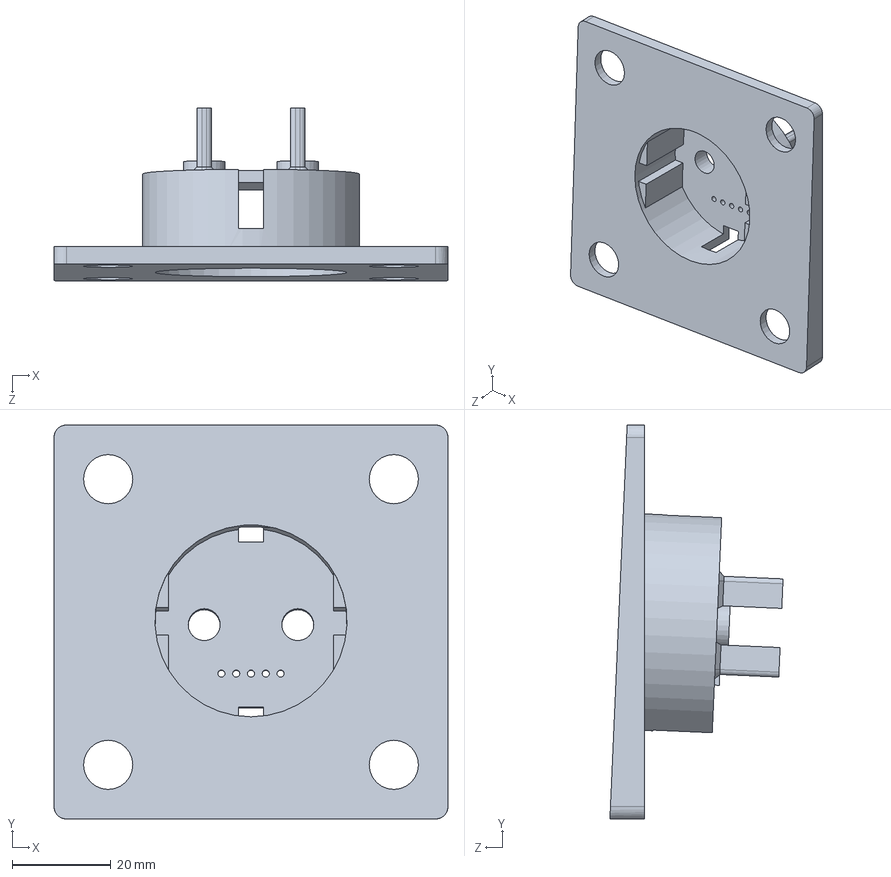
[picture p77: CAD file, 2018-08-08]
3d-case-drawing/socket-single.SLDPRT
80.0 x 80.0 x 35.2 mm
