vberkaltun/nodemcu-firmware-documentation/3d-case-drawing/socket-multi.SLDPRT

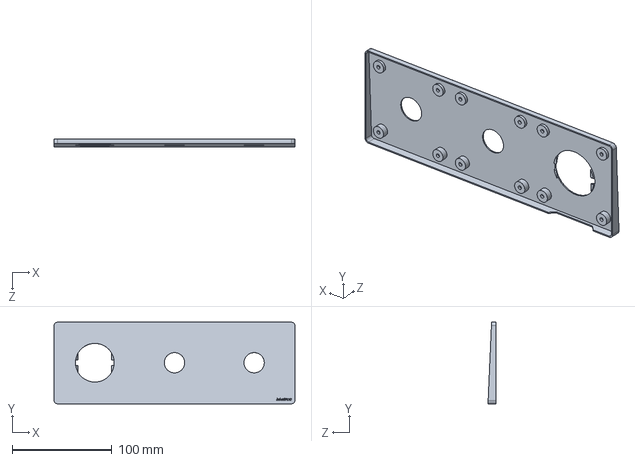
[picture p78: CAD file, 2018-08-08]
3d-case-drawing/socket-multi.SLDPRT
242.0 x 82.0 x 8.04 mm
