vberkaltun/nodemcu-firmware-documentation/3d-case-drawing/socket-single-cover.SLDPRT

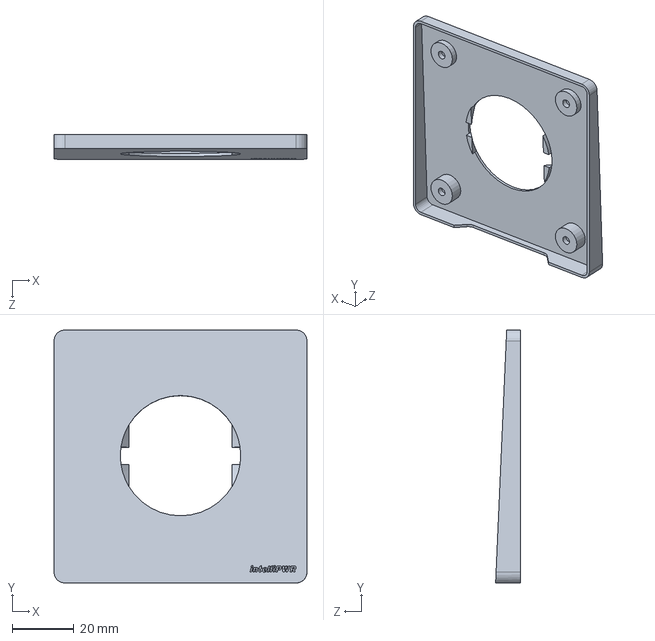
[picture p79: CAD file, 2018-08-08]
3d-case-drawing/socket-single-cover.SLDPRT
82.0 x 82.0 x 8.04 mm
