vberkaltun/nodemcu-firmware-documentation/3d-case-drawing/socket-single-bonding.SLDPRT

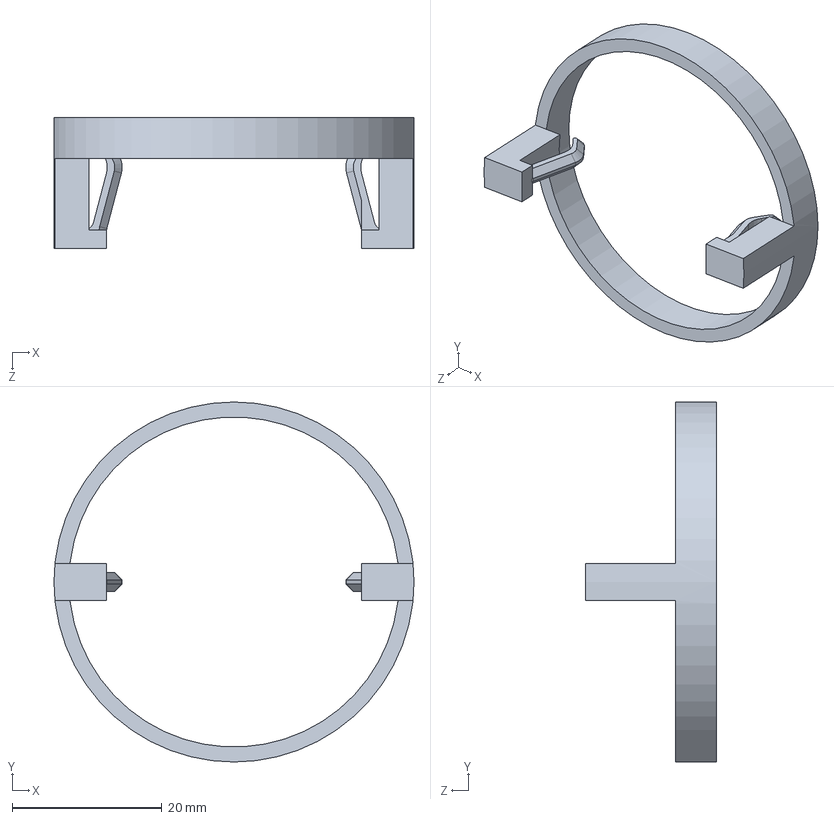
[picture p80: CAD file, 2018-08-08]
3d-case-drawing/socket-single-bonding.SLDPRT
48.0 x 48.0 x 17.5 mm
