vberkaltun/nodemcu-firmware-documentation/3d-case-drawing/socket-single-pin.SLDPRT

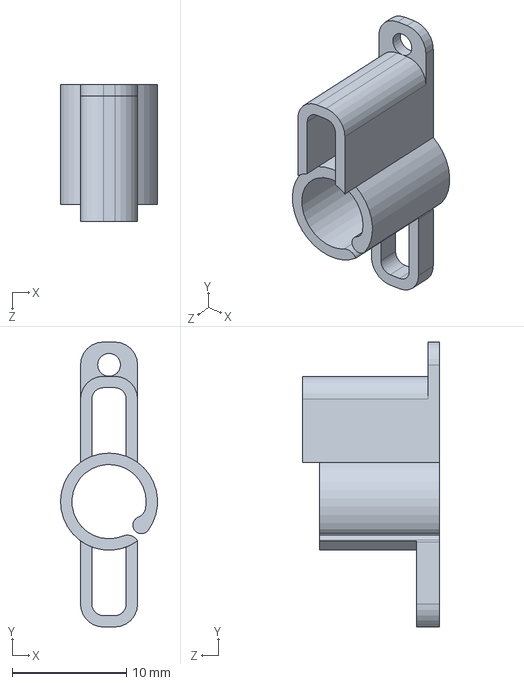
[picture p81: CAD file, 2018-08-08]
3d-case-drawing/socket-single-pin.SLDPRT
8.49 x 25.0 x 12.0 mm
