vberkaltun/nodemcu-firmware-documentation/3d-case-drawing/socket-single-led.SLDPRT

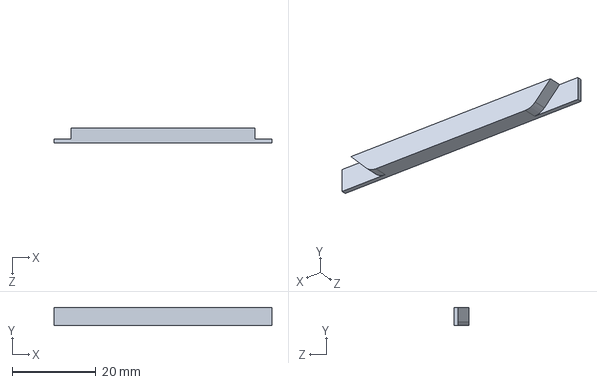
[picture p82: CAD file, 2018-08-08]
3d-case-drawing/socket-single-led.SLDPRT
52.0 x 4.39 x 3.50 mm
