vberkaltun/nodemcu-firmware-documentation/3d-case-drawing/socket-single-lock.SLDPRT

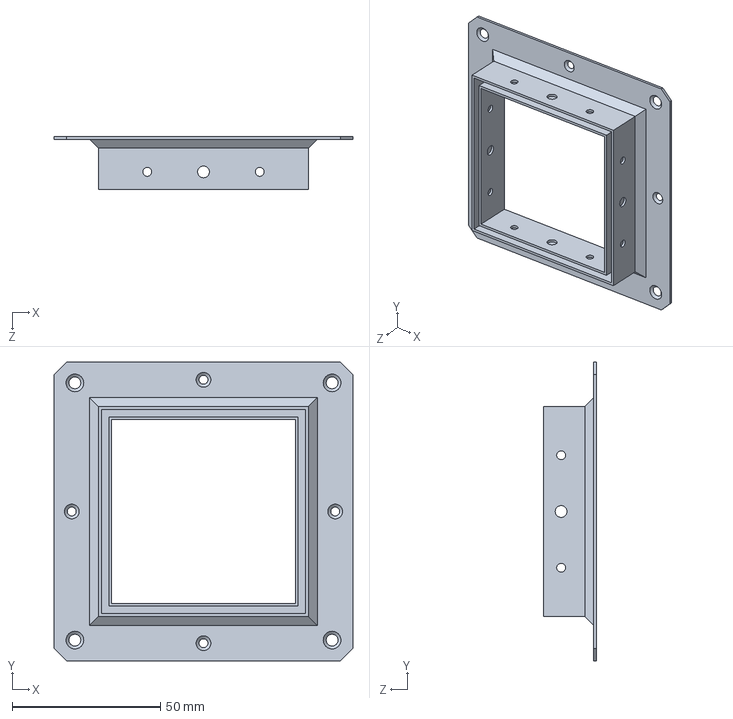
[picture p83: CAD file, 2018-08-08]
3d-case-drawing/socket-single-lock.SLDPRT
101.0 x 101.0 x 18.0 mm
