vberkaltun/nodemcu-firmware-documentation/3d-case-drawing/socket-case.SLDPRT

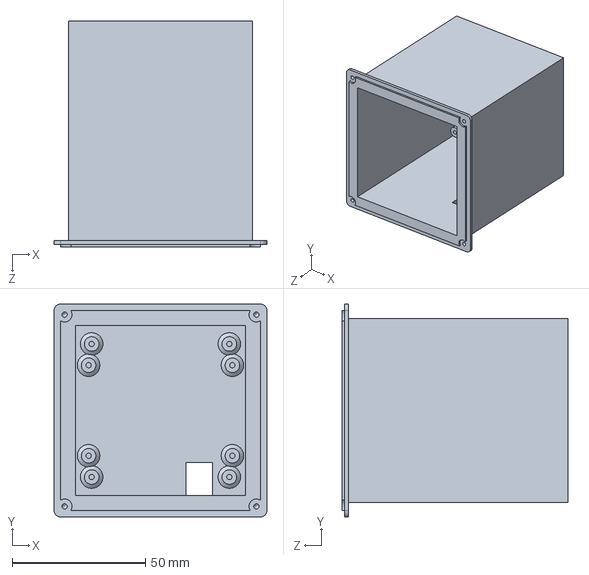
[picture p84: CAD file, 2018-05-20]
3d-case-drawing/socket-case.SLDPRT
80.0 x 80.0 x 85.0 mm
