vberkaltun/nodemcu-firmware-documentation/3d-case-drawing/inside-male.SLDPRT

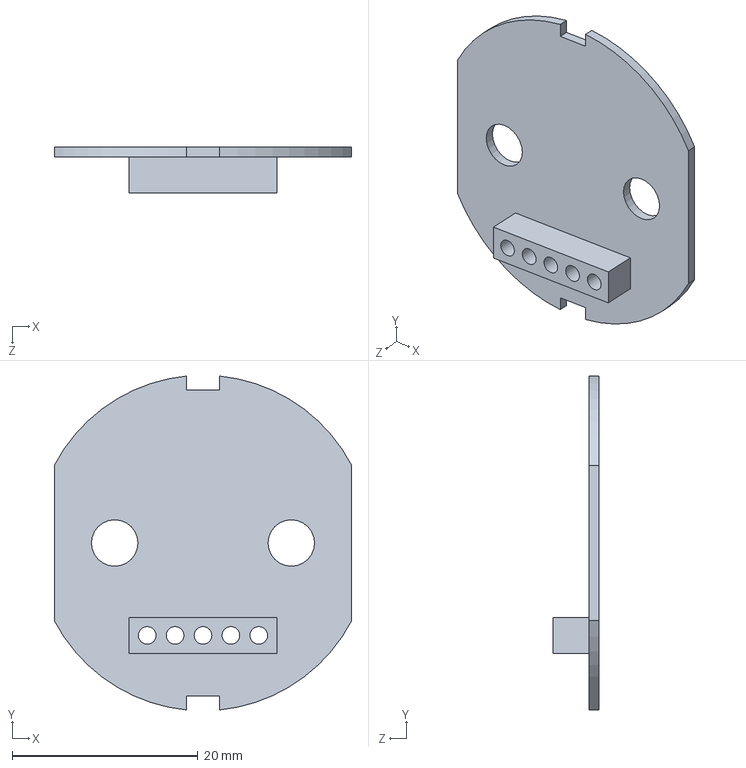
[picture p85: CAD file, 2018-05-20]
3d-case-drawing/inside-male.SLDPRT
32.0 x 35.9 x 5.00 mm
