vberkaltun/nodemcu-firmware-documentation/3d-case-drawing/inside-female.SLDPRT

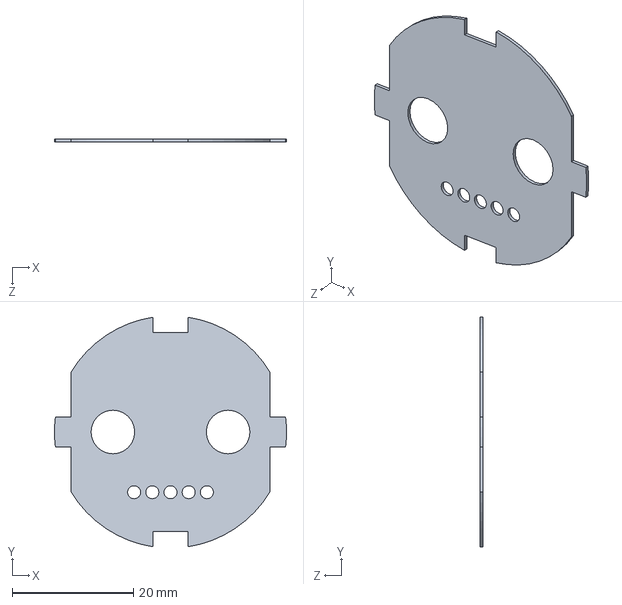
[picture p86: CAD file, 2018-05-20]
3d-case-drawing/inside-female.SLDPRT
38.3 x 37.9 x 0.5 mm
