vberkaltun/nodemcu-firmware-documentation/(list of files, drawings)

Other design files:
thesis-fritzing/arduino.fzz
thesis-fritzing/nodemcu.fzz
