vberkaltun/nodemcu-firmware-documentation/(commit log)

2018-05-20 3D case drawing was added
    [inside-female.SLDPRT, inside-male.SLDPRT, socket-female.SLDPRT, socket-male.SLDPRT]
2018-05-23 in process...
    [nodemcu.fzz]
2018-06-29 Socket Cover was added
    [socket-cover.SLDPRT]
2018-06-29 0.6mm bossed
    [socket-cover.SLDPRT]
2018-06-29 Boss was deleted, Filigran was added as "intelliPWR"
    [socket-cover.SLDPRT]
2018-08-08 All case draws were added
    [assembly-multi.SLDASM, assembly-single.SLDASM, inside-female.SLDPRT, inside-male.SLDPRT, socket-case.SLDPRT, socket-cover.SLDPRT, socket-male.SLDPRT, socket-multi.SLDPRT]
